MichaelPate/Reflow-Oven-Controller/Control Board/ImagesForFeedbacl/version100/board render angled.png

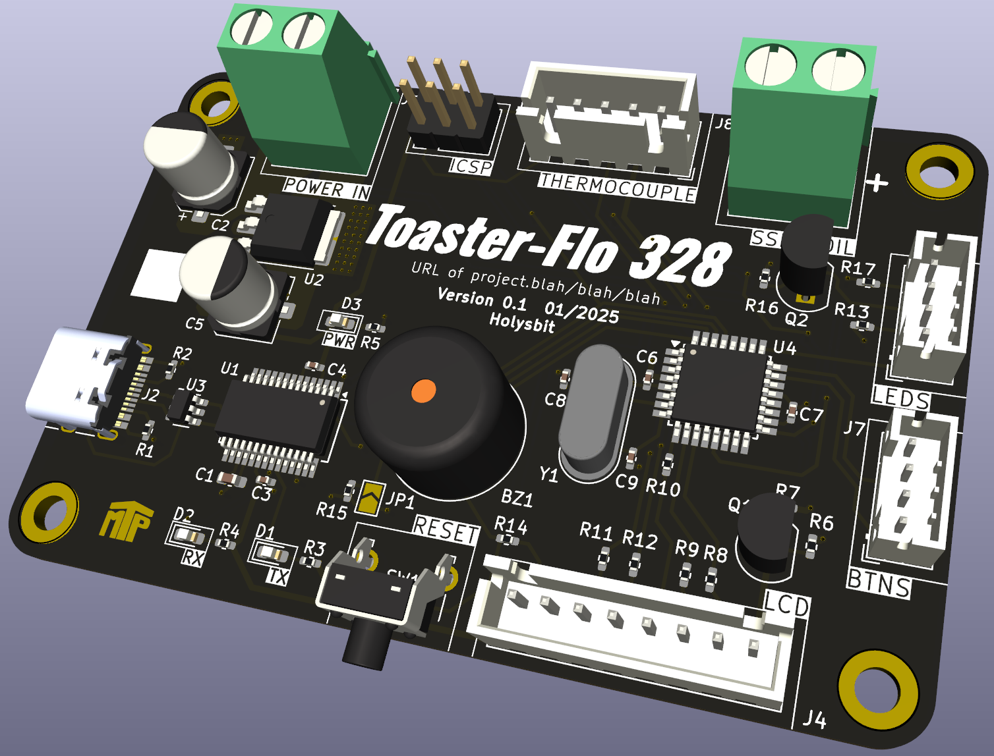
Control Board/ImagesForFeedbacl/version100/board render angled.png
