MichaelPate/Reflow-Oven-Controller/README.md

Toaster-Flo-1769877793309
