MichaelPate/Reflow-Oven-Controller/Control Board/ImagesForFeedbacl/version100/board render straight on.png

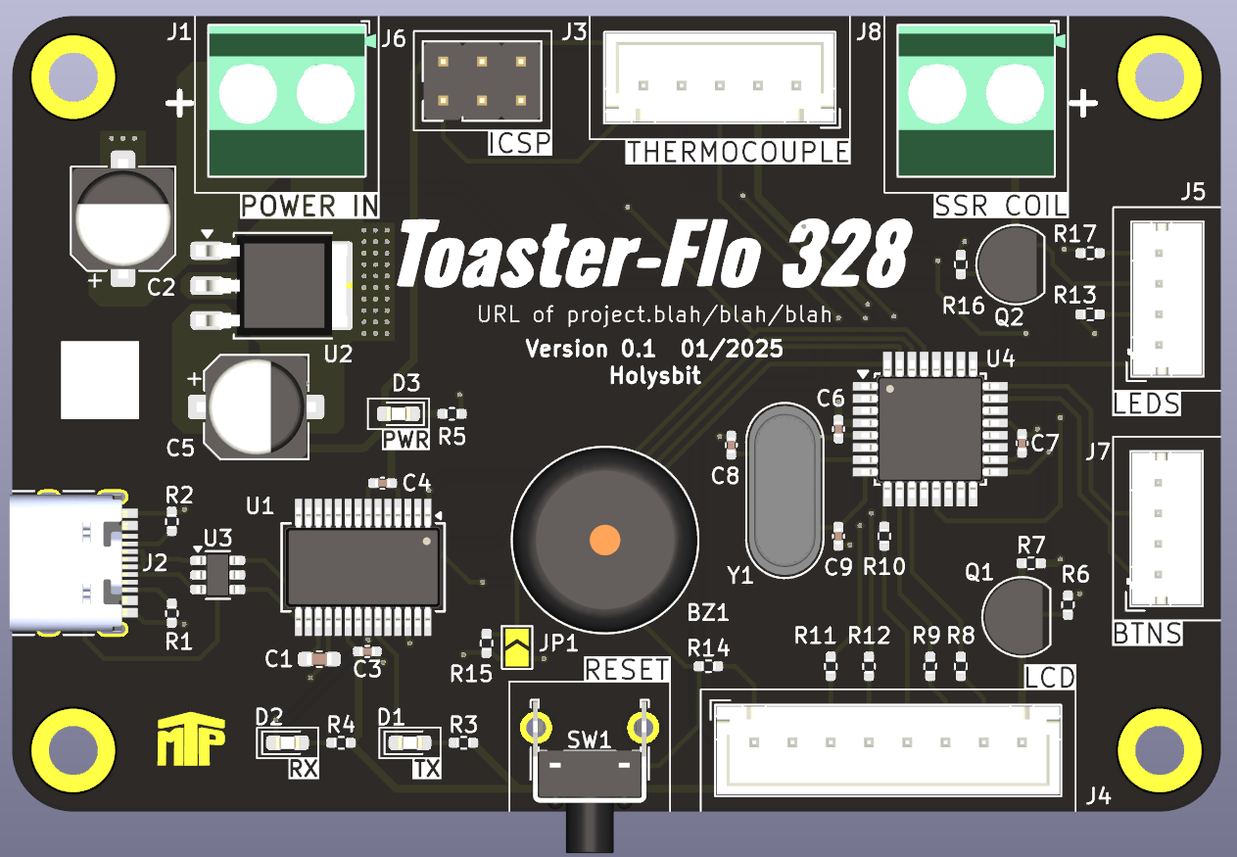
Control Board/ImagesForFeedbacl/version100/board render straight on.png
