MichaelPate/Reflow-Oven-Controller/Control Board/ImagesForFeedbacl/version100/full pcb view all layers.png

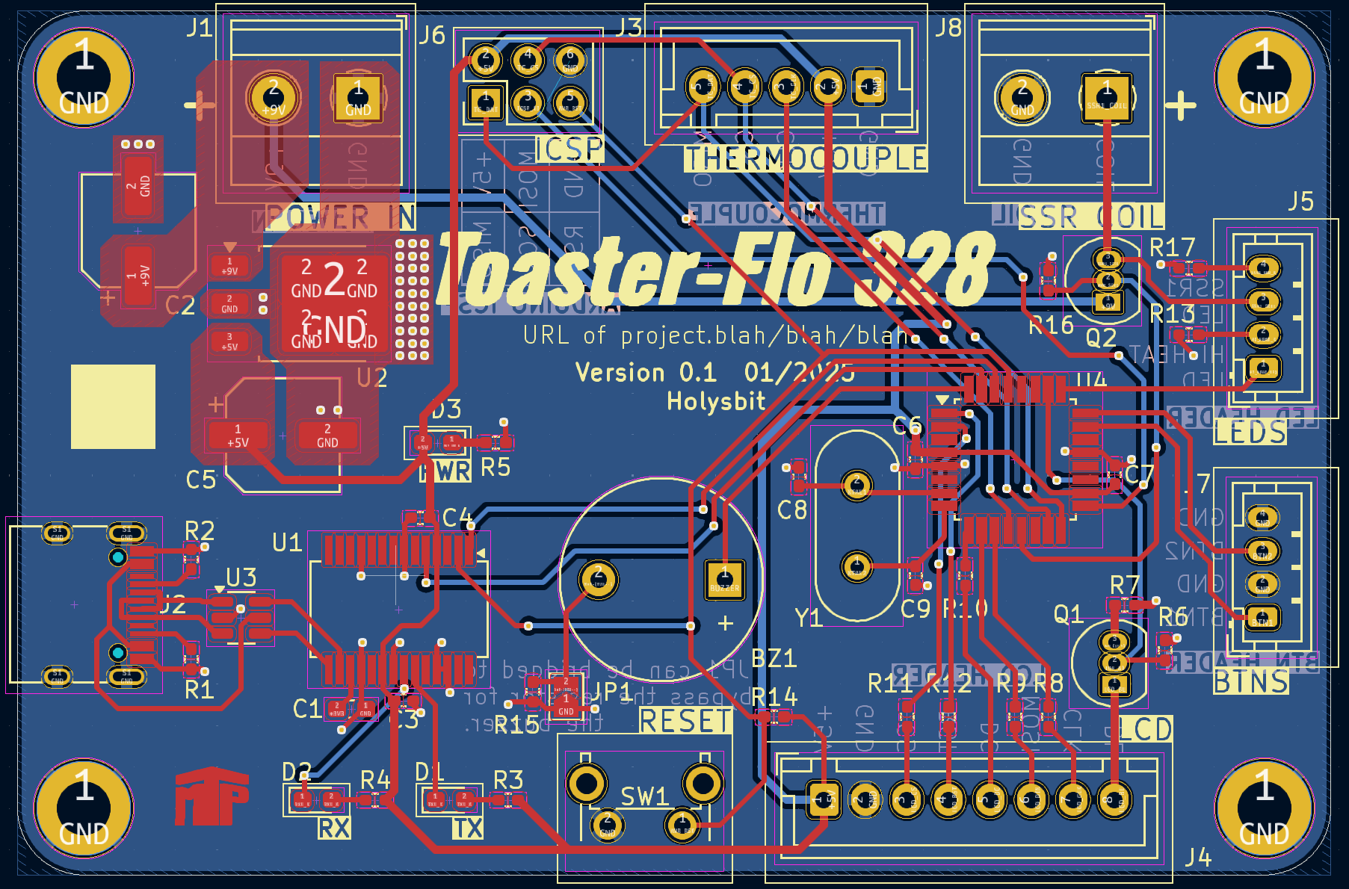
Control Board/ImagesForFeedbacl/version100/full pcb view all layers.png
