MichaelPate/Reflow-Oven-Controller/Control Board/ImagesForFeedbacl/version100/pcb view bottom layer.png

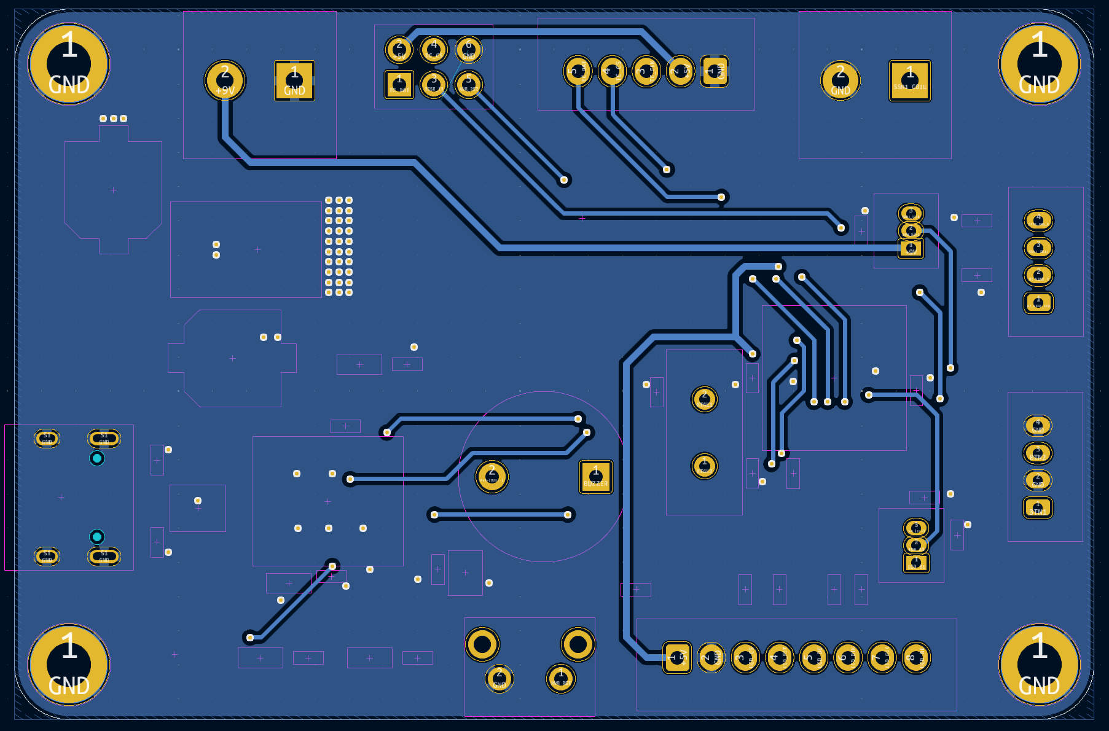
Control Board/ImagesForFeedbacl/version100/pcb view bottom layer.png
