MichaelPate/Reflow-Oven-Controller/Control Board/ImagesForFeedbacl/version100/pcb view top layer.png

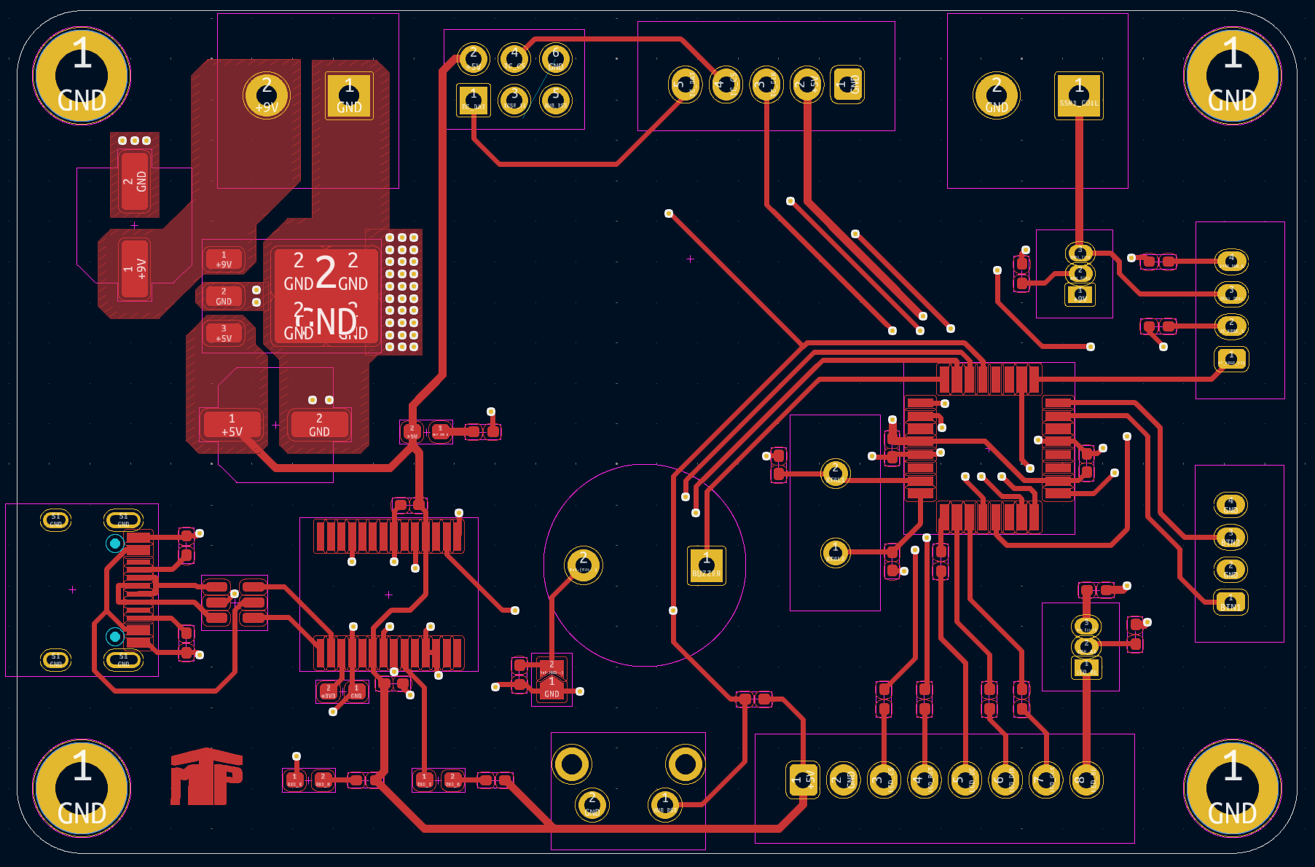
Control Board/ImagesForFeedbacl/version100/pcb view top layer.png
