MichaelPate/Reflow-Oven-Controller/Control Board/ImagesForFeedbacl/version100/schematic.png

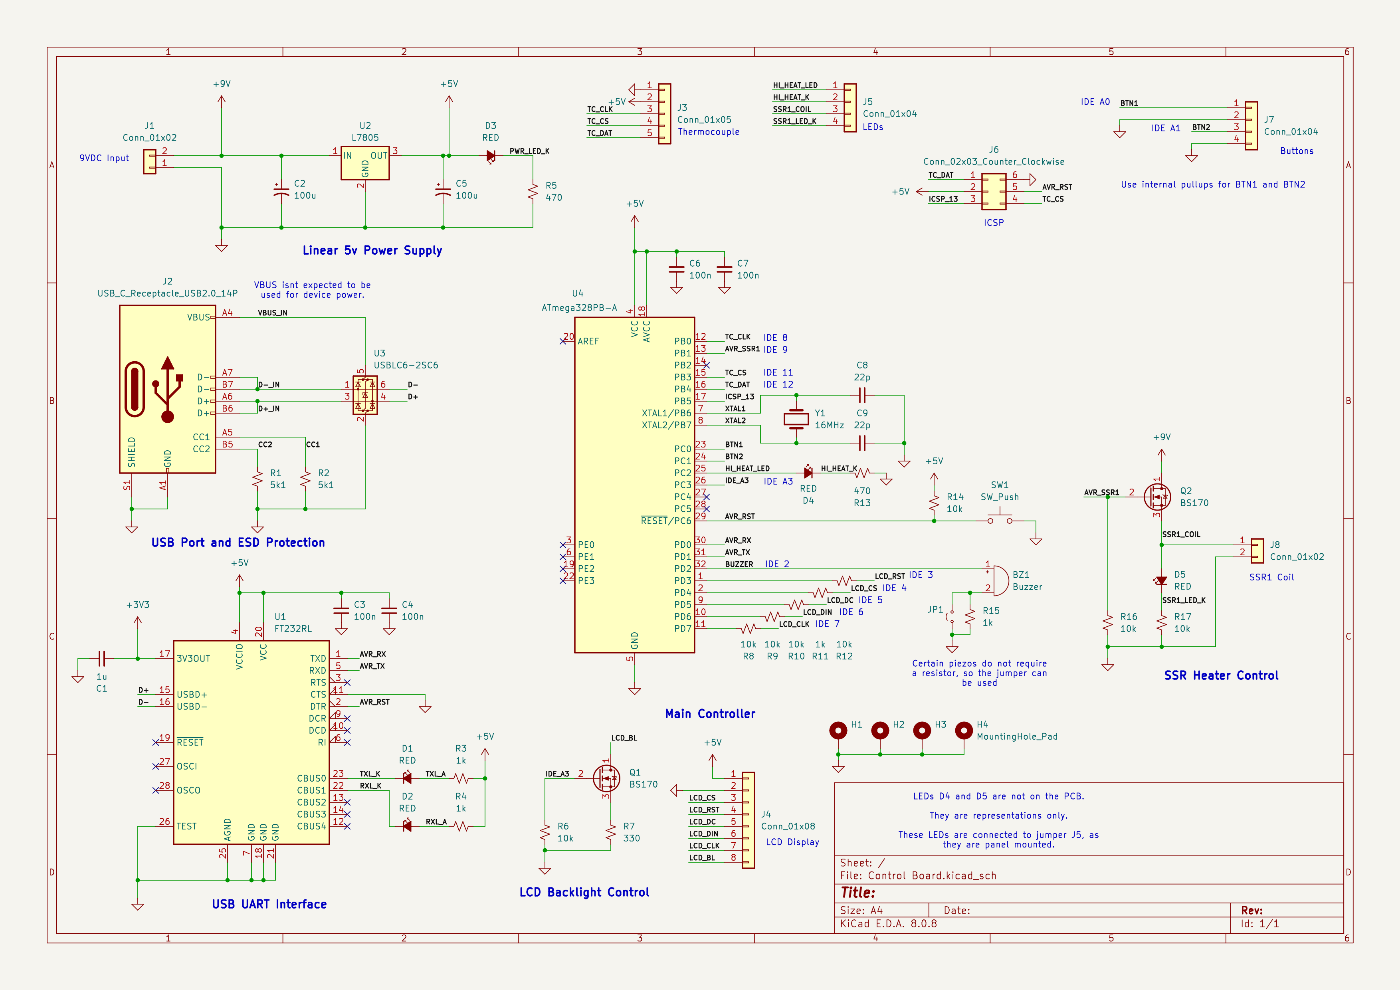
Control Board/ImagesForFeedbacl/version100/schematic.png
