MichaelPate/Reflow-Oven-Controller/Control Board/Control Board.ods

Id | Designator | Footprint | QTY | Designation | Supplier | Mfg PN | Order QTY | Ext. Price | Unit Price
27 | REF** | MTP Logo 5mm Low Detail Copper | 1 | MTP Logo 5mm Low Detail Copper | Not a real part | Not a real part | Not a real part | Not a real part | Not a real part
32 | REF** | michaelpate.net QR Code 5mm | 1 | michaelpate.net QR Code 5mm | Not a real part | Not a real part | Not a real part | Not a real part | Not a real part
30 | C12 | C_0603_1608Metric | 1 | 1u | LCSC | CGA0603X5R105K160JT | 200 | $0.62 | $0.0031
4 | C15,C1,C7,C2,C5,C6 | C_0402_1005Metric | 6 | 100n | LCSC | CGA0402X7R104K160GT | 1000 | $0.60 | $0.0006
23 | C16 | C_0402_1005Metric | 1 | 220n | LCSC | CGA0402X5R224K100GT | 200 | $0.32 | $0.0016
14 | C4 | C_0402_1005Metric | 1 | 10n | LCSC | CGA0402X7R103M500GT | 1000 | $0.70 | $0.0007
18 | C9,C8 | C_0402_1005Metric | 2 | 22p | LCSC | CGA0402C0G220J500GT | 500 | $0.45 | $0.0009
29 | D6,D7 | D_SOD-123 | 2 | MBR0520T1G-JSM | LCSC | MBR0520T1G-JSM | 80 | $2.47 | $0.0309
15 | D8,D2,D3 | LED_0603_1608Metric | 3 | RED | LCSC | XL-1608SURC-06 | 1000 | $2.40 | $0.0024
16 | F2 | Fuse_0603_1608Metric_Pad1.05x0.95mm_HandSolder | 1 | 0603L020/6XR | LCSC | 0603L020/6XR | 60 | $2.63 | $0.0438
26 | FB2 | L_0402_1005Metric | 1 | 33R100MHz | LCSC | CBG100505U330T | 200 | $0.58 | $0.0029
2 | J1,J8 | TerminalBlock_Phoenix_MKDS-1,5-2-5.08_1x02_P5.08mm_Horizontal | 2 | Conn_01x02 | LCSC | JL500-50802G01 | 50 | $5.83 | $0.1166
7 | J2 | USB_C_Receptacle_HRO_TYPE-C-31-M-12 | 1 | USB_C_Receptacle_USB2.0_14P | LCSC | TYPE-C-31-M-12 | 100 | $13.67 | $0.1367
20 | J3 | JST_XH_B5B-XH-A_1x05_P2.50mm_Vertical | 1 | Conn_01x05 | LCSC | B5B-XH-A(LF)(SN) | 35 | $2.52 | $0.0720
21 | J4 | JST_XH_B8B-XH-A_1x08_P2.50mm_Vertical | 1 | Conn_01x08 | LCSC | B8B-XH-A(LF)(SN) | 20 | $1.98 | $0.0990
19 | J6 | PinHeader_2x03_P2.54mm_Vertical | 1 | Conn_02x03_Counter_Clockwise | LCSC | P125-1140A0BS116A1 | 25 | $5.32 | $0.2128
3 | J7,J5 | JST_PH_B4B-PH-K_1x04_P2.00mm_Vertical | 2 | Conn_01x04 | LCSC | B4B-PH-K-S(LF)(SN) | 50 | $1.99 | $0.0398
5 | Q4,Q3 | SOT-23 | 2 | AO3414-HXY | LCSC | AO3414-HXY | 150 | $2.25 | $0.0150
11 | R1,R2 | R_0402_1005Metric | 2 | 5k1 | LCSC | RTT02512JTH | 1000 | $0.40 | $0.0004
9 | R13,R9 | R_0402_1005Metric | 2 | 470 | LCSC | RTT02471JTH | 1000 | $0.40 | $0.0004
6 | R16,R21,R14,R20,R18,R17,R6,R22 | R_0402_1005Metric | 8 | 10k | LCSC | SCR0402J10K | 1000 | $0.30 | $0.0003
1 | R5,R19,R4,R15 | R_0402_1005Metric | 4 | 1k | LCSC | SCR0402J1K | 1000 | $0.30 | $0.0003
24 | R7 | R_0402_1005Metric | 1 | 330 | LCSC | SCR0402F330R | 1000 | $0.40 | $0.0004
31 | R8 | R_0402_1005Metric | 1 | 0 | LCSC | SCR0402J0R | 1000 | $0.30 | $0.0003
17 | SW1 | SW_Tactile_SPST_Angled_PTS645Vx58-2LFS | 1 | SW_Push | LCSC | PTS645VL83-2 LFS | 55 | $3.82 | $0.0695
8 | U1 | TO-252-3_TabPin2 | 1 | L7805 | LCSC | BA7805FP-E2 | 40 | $13.66 | $0.3415
25 | U2 | SOT-23-6 | 1 | USBLC6-2SC6 | LCSC | USBLC6-2SC6 | 100 | $1.65 | $0.0165
13 | U3 | SSOP-28_5.3x10.2mm_P0.65mm | 1 | FT232RL | LCSC | FT232RL-REEL | 6 | $24.65 | $4.1083
22 | U5 | TQFP-32_7x7mm_P0.8mm | 1 | ATmega328PB-A | LCSC | ATMEGA328PB-AU | 10 | $17.50 | $1.7500
28 | Y2 | Crystal_SMD_3225-4Pin_3.2x2.5mm | 1 | 16MHz | LCSC | CF4016M00020001 | 40 | $2.19 | $0.0548
10 | C13 | CP_Elec_4x5.4 | 1 | 4u7 | DigiKey | 10SVP4R7M | 5 | $6.60 | $1.3200
12 | BZ1 | Buzzer_12x9.5RM7.6 | 1 | Buzzer | Amazon | CYT1008 | 10 | $5.99 | $0.5990
 |  |  |  |  |  |  |  | $122.49
