MichaelPate/Reflow-Oven-Controller/Control Board/plots/Control Board__Assembly.pdf

1 | 2 | 3 | 4 | 5 | 6

A

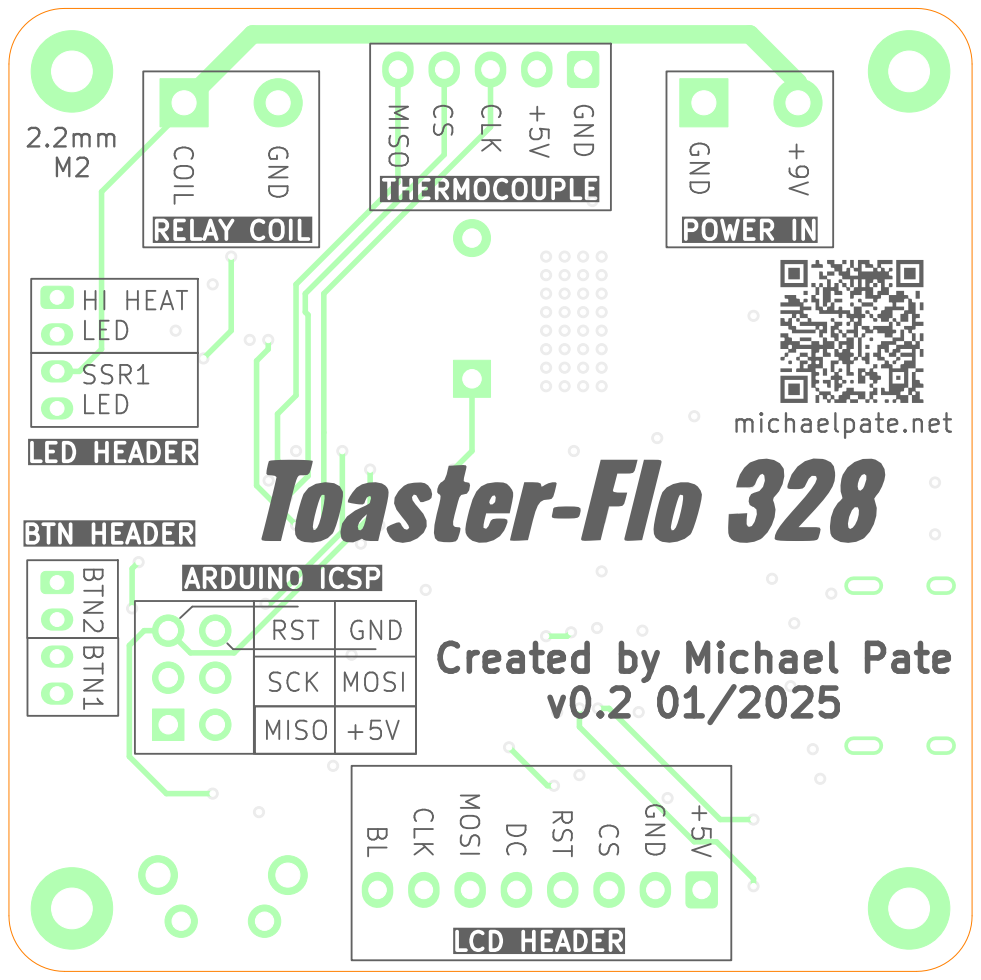
[picture p8: page 1]
RST MISO BTN1; Created; Michael; Pate; v0.2 01/2025 MOSI; CLK +5V DC CLKBL COIL; GND MOSI BTN2; 2.2mm M2SSR1; LED; GND; michaelpate.net CS HI; HEAT; SCK GND; +5V MISO; RST GND; D Date: KiCad; E.D.A. 8.0.8 Size: A4; Rev:; Id: 1/1 Title: File: Control; Board.kicad_pcb Sheet: Colored; BOT Board2Pdf:; Colored; BOT -; Page

1 | 2 | 3 | 4 | 5 | 6

A

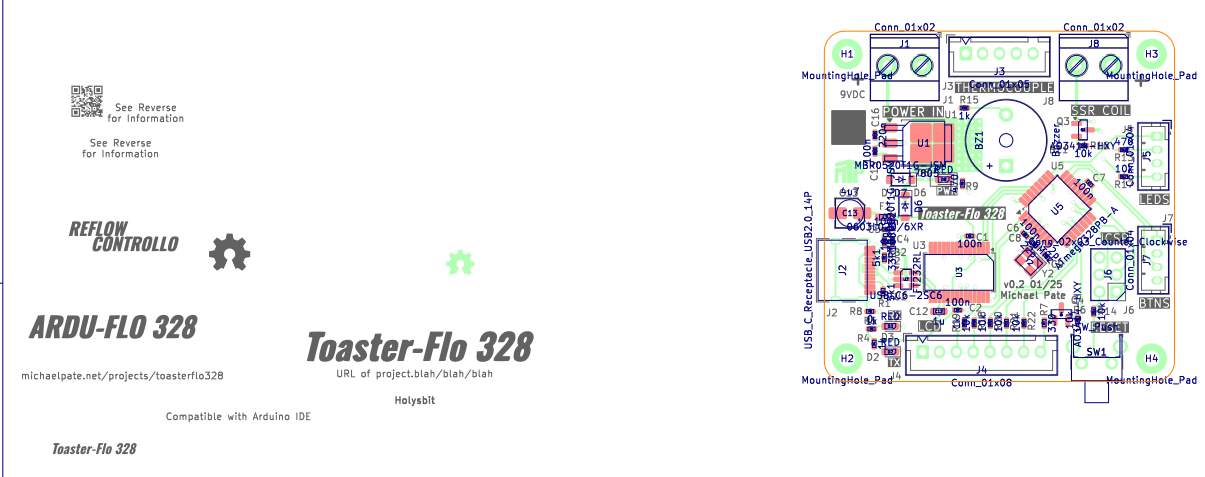
[picture p9: page 2]
