MichaelPate/Reflow-Oven-Controller/Hardware/TC Front End/front-end/front-end.kicad_pcb

## KiCad design Hardware/TC Front End/front-end/front-end.kicad_pcb (2025-10-18)

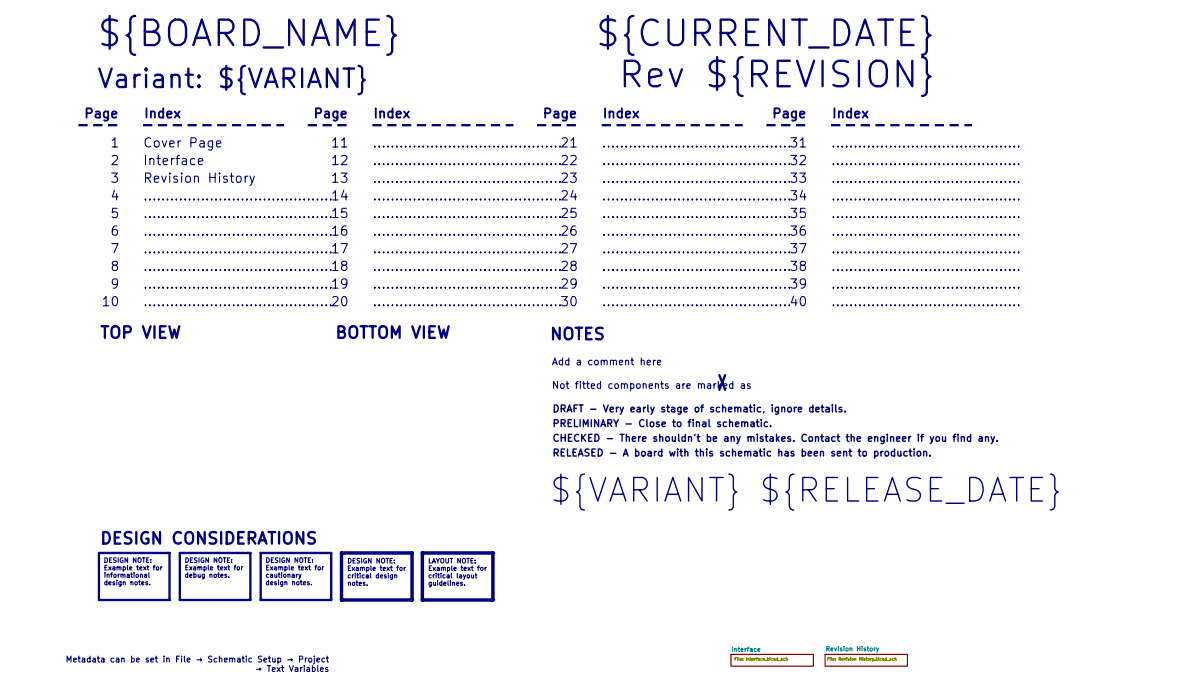
[picture p10: schematic front-end.kicad_sch, Cover Page]

Notes on the sheet:
BOTTOM VIEW
...........................................
RELEASED - A board with this schematic has been sent to production.
Page
TOP VIEW
Not fitted components are marked as
Index
PRELIMINARY - Close to final schematic.
${VARIANT} ${RELEASE_DATE}
${CURRENT_DATE}
Variant: ${VARIANT}
Rev ${REVISION}
${BOARD_NAME}
DRAFT - Very early stage of schematic, ignore details.
Interface
Add a comment here
Cover Page
NOTES
Revision History
CHECKED - There shouldn't be any mistakes. Contact the engineer if you find any.
DESIGN CONSIDERATIONS
Metadata can be set in File → Schematic Setup → Project → Text Variables
DESIGN NOTE: Example text for informational design notes.
LAYOUT NOTE: Example text for critical layout guidelines.
DESIGN NOTE: Example text for cautionary design notes.
DESIGN NOTE: Example text for debug notes.
DESIGN NOTE: Example text for critical design notes.


Notes on the sheet:
- _________________________________ - _________________________________ - _________________________________ - _________________________________ - _________________________________ - _________________________________ - _________________________________ - _________________________________ - _________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
DD.MM.YYYY - xxx Revision Variant: xxx
[${#}] ${TITLE}

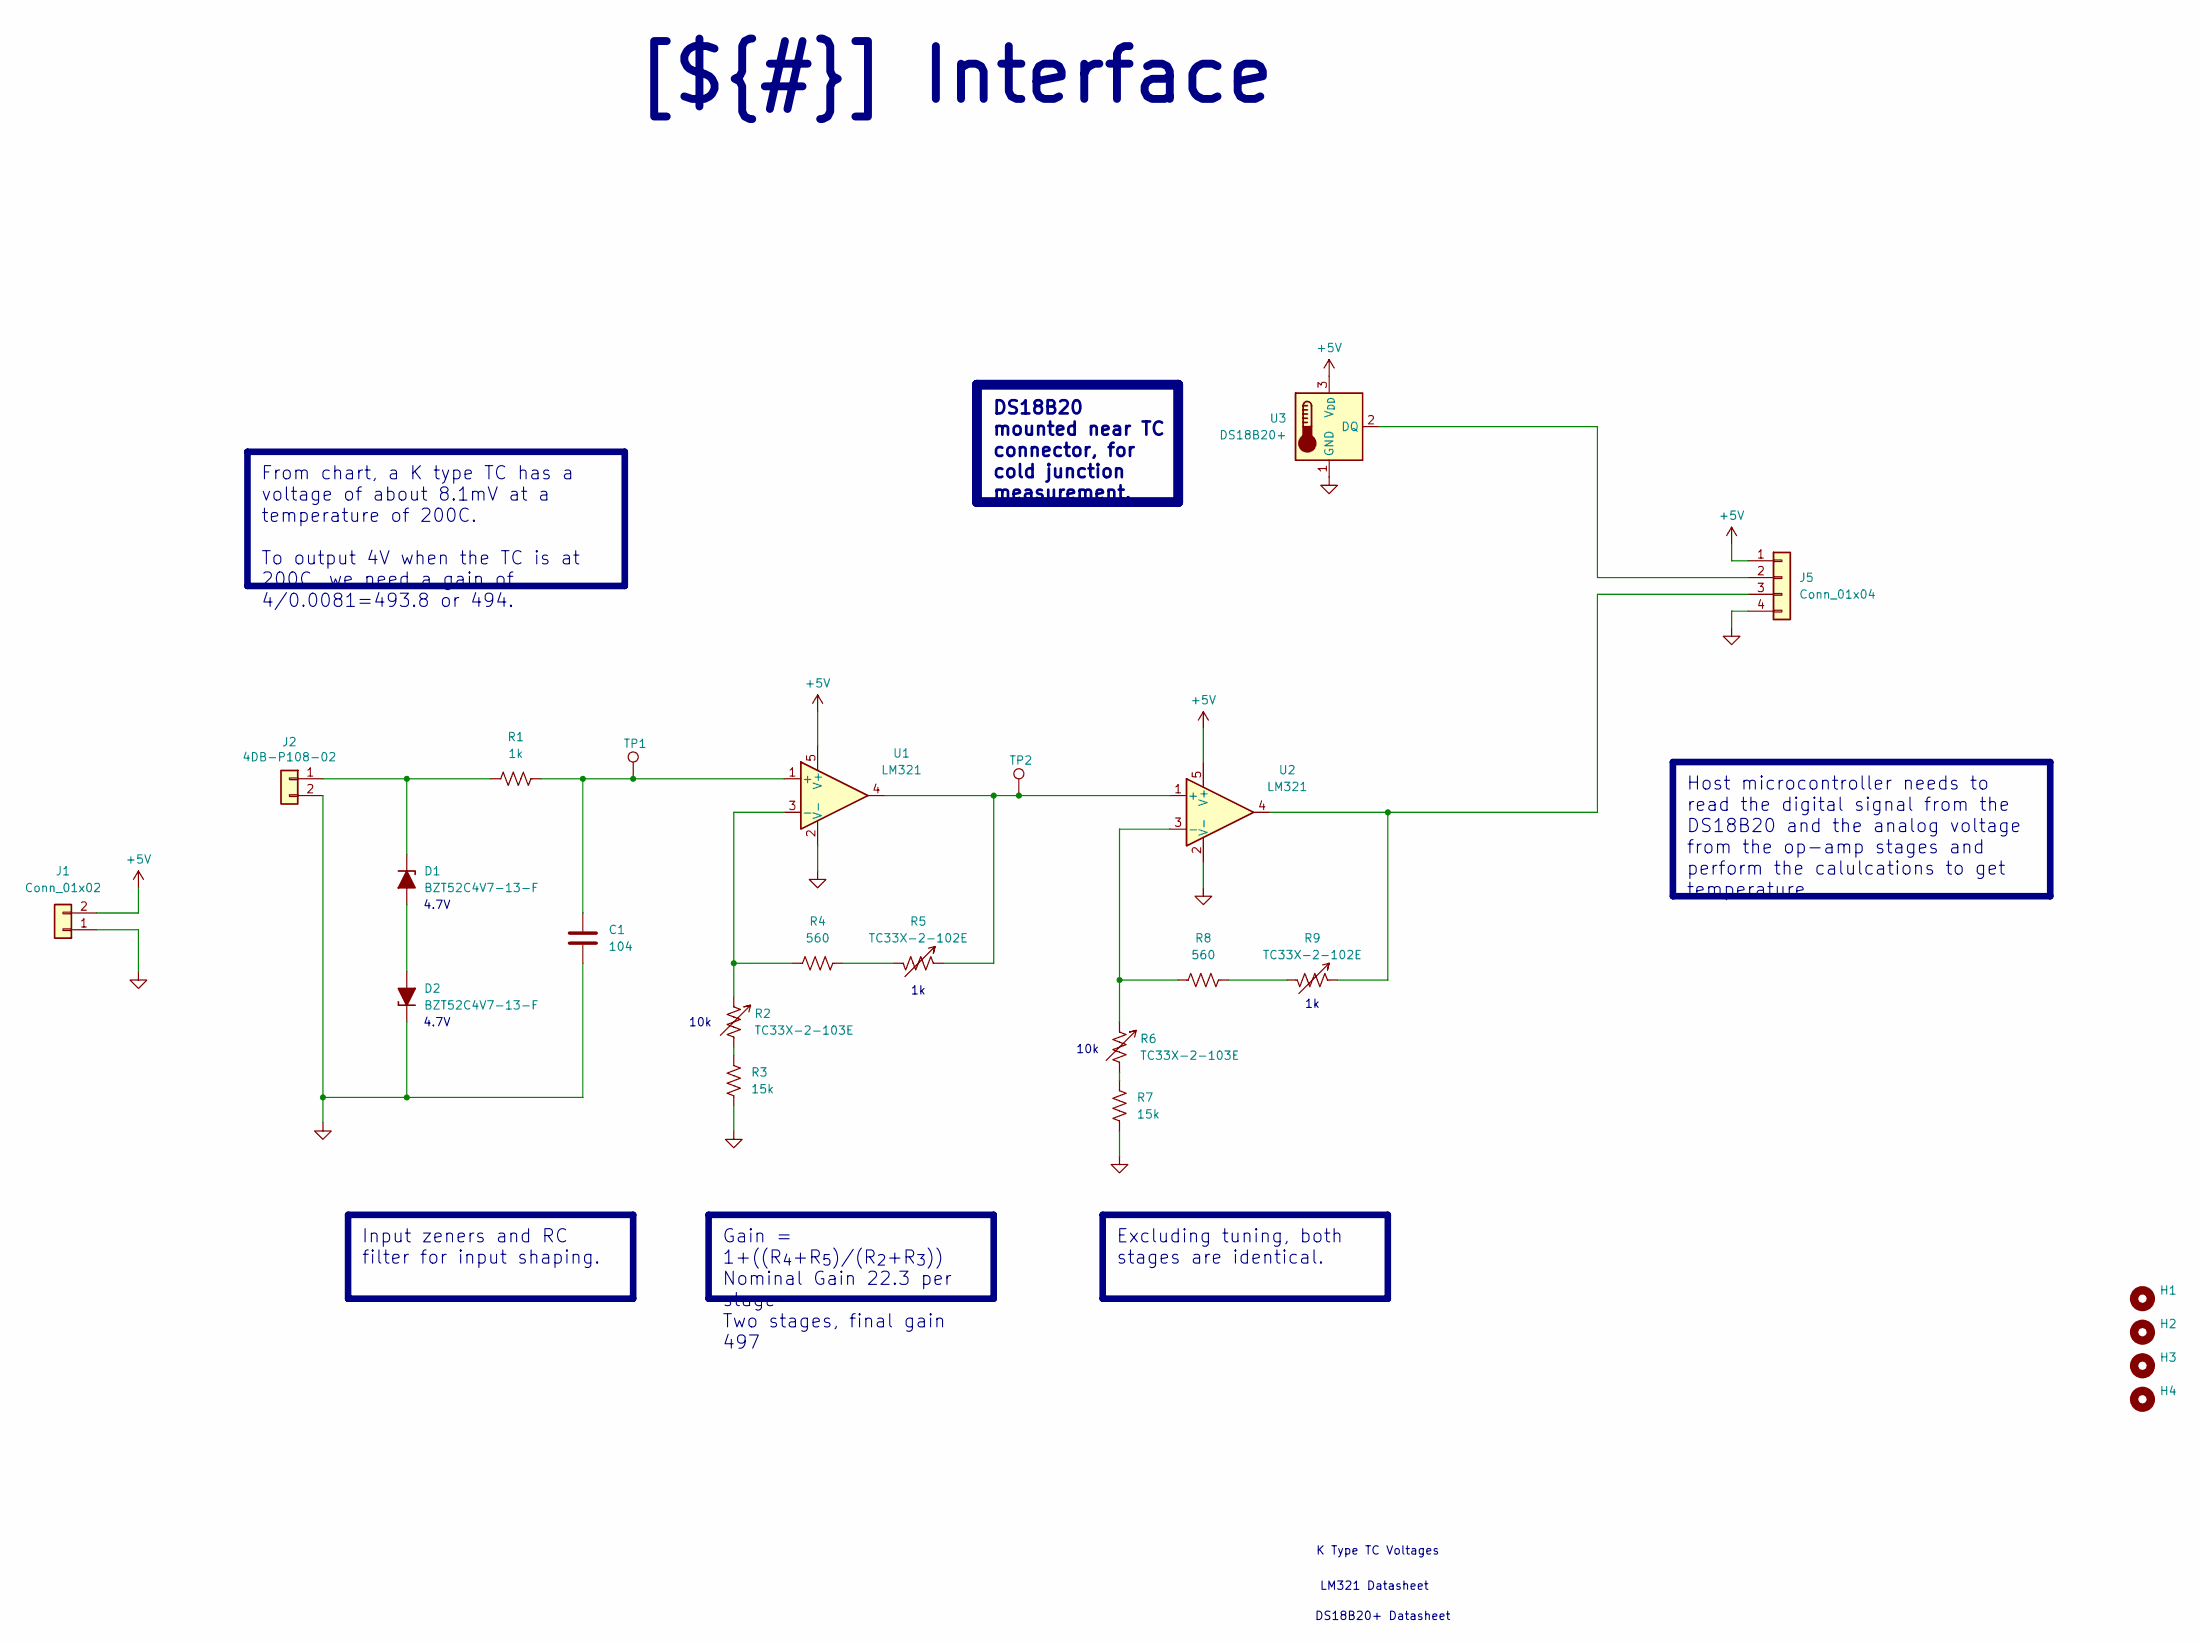
[picture p12: schematic Interface.kicad_sch]

Parts:
C1: 104; C_0603_1608Metric_Pad1.08x0.95mm_HandSolder
D1, D2: BZT52C4V7-13-F; D_SOD-123
H1, H2, H3, H4: MountingHole; MountingHole_3.2mm_M3
J1: Conn_01x02; TerminalBlock_Phoenix_MKDS-1,5-2_1x02_P5.00mm_Horizontal
J2: 4DB-P108-02; CONN_4DB-P108-02_TEC
J5: Conn_01x04; PinHeader_1x04_P2.54mm_Vertical
R1: 1k; R_0603_1608Metric_Pad0.98x0.95mm_HandSolder
R2, R6: TC33X-2-103E; Potentiometer_Bourns_TC33X_Vertical
R3, R7: 15k; R_0603_1608Metric_Pad0.98x0.95mm_HandSolder
R4, R8: 560; R_0603_1608Metric_Pad0.98x0.95mm_HandSolder
R5, R9: TC33X-2-102E; Potentiometer_Bourns_TC33X_Vertical
TP1, TP2: TestPoint; TestPoint_THTPad_D2.0mm_Drill1.0mm
U1, U2: LM321; SOT-23-5
U3: DS18B20+; TO-92_Inline

Connections:
+5V: J1.2, J5.1, U1.5 (V+), U2.5 (V+), U3.3 (V_{DD})
GND: C1.2, D2.1 (K), J1.1, J2.2, J5.4, R3.2, R7.2, U1.2 (V-), U2.2 (V-), U3.1 (GND)
unnamed: D1.2 (A), D2.2 (A)
unnamed: D1.1 (K), J2.1, R1.1
unnamed: J5.2, U3.2 (DQ)
unnamed: J5.3, R9.1, U2.4
unnamed: R2.2, R3.1
unnamed: R4.2, R5.2
unnamed: R6.2, R7.1
unnamed: R8.2, R9.2
unnamed: C1.1, R1.2, TP1.1, U1.1 (+)
unnamed: R2.1, R4.1, U1.3 (-)
unnamed: R5.1, TP2.1, U1.4, U2.1 (+)
unnamed: R6.1, R8.1, U2.3 (-)

Notes on the sheet:
4.7V
K Type TC Voltages
10k
LM321 Datasheet
DS18B20+ Datasheet
DS18B20 mounted near TC connector, for cold junction measurement.
Gain = 1+((R_{4}+R_{5})/(R_{2}+R_{3})) Nominal Gain 22.3 per stage Two stages, final gain 497
Input zeners and RC filter for input shaping.
Excluding tuning, both stages are identical.
[${#}] ${TITLE}
Host microcontroller needs to read the digital signal from the DS18B20 and the analog voltage from the op-amp stages and perform the calulcations to get temperature.
From chart, a K type TC has a voltage of about 8.1mV at a temperature of 200C. To output 4V when the TC is at 200C, we need a gain of 4/0.0081=493.8 or 494.

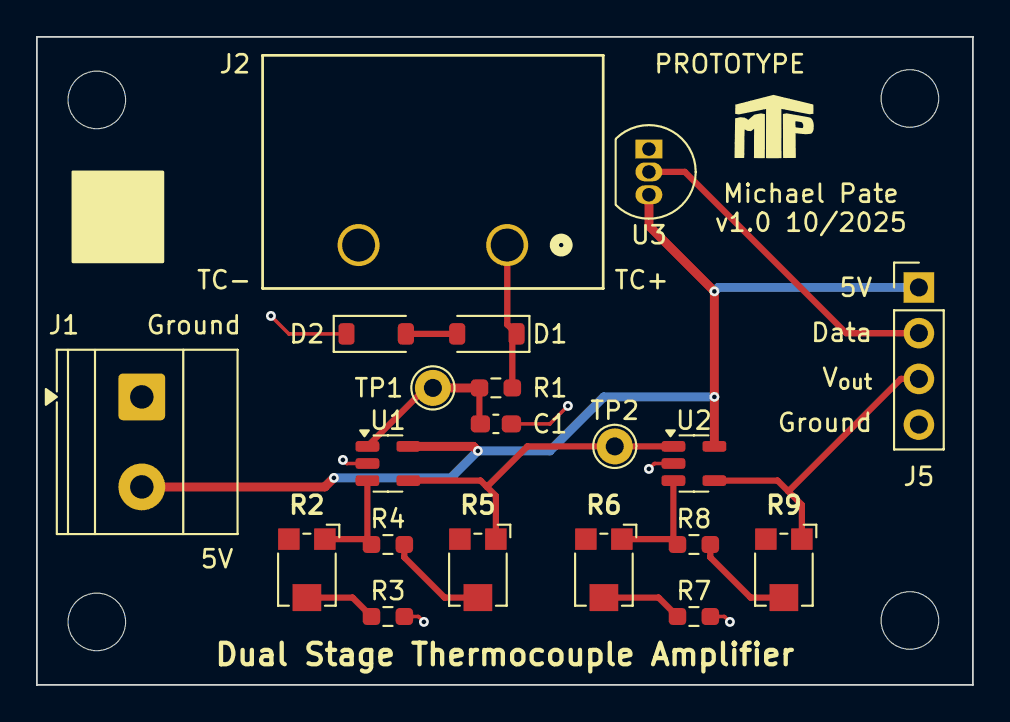
[picture p13: board front-end.kicad_pcb from above]

Board: 2 copper layers, 52.0 x 36.0 mm, 24 parts (0 on the bottom side), 14 nets.
