MichaelPate/Reflow-Oven-Controller/Hardware/Power Board/powerBoard/powerBoard.kicad_pcb

## KiCad design Hardware/Power Board/powerBoard/powerBoard.kicad_pcb (2025-10-24)

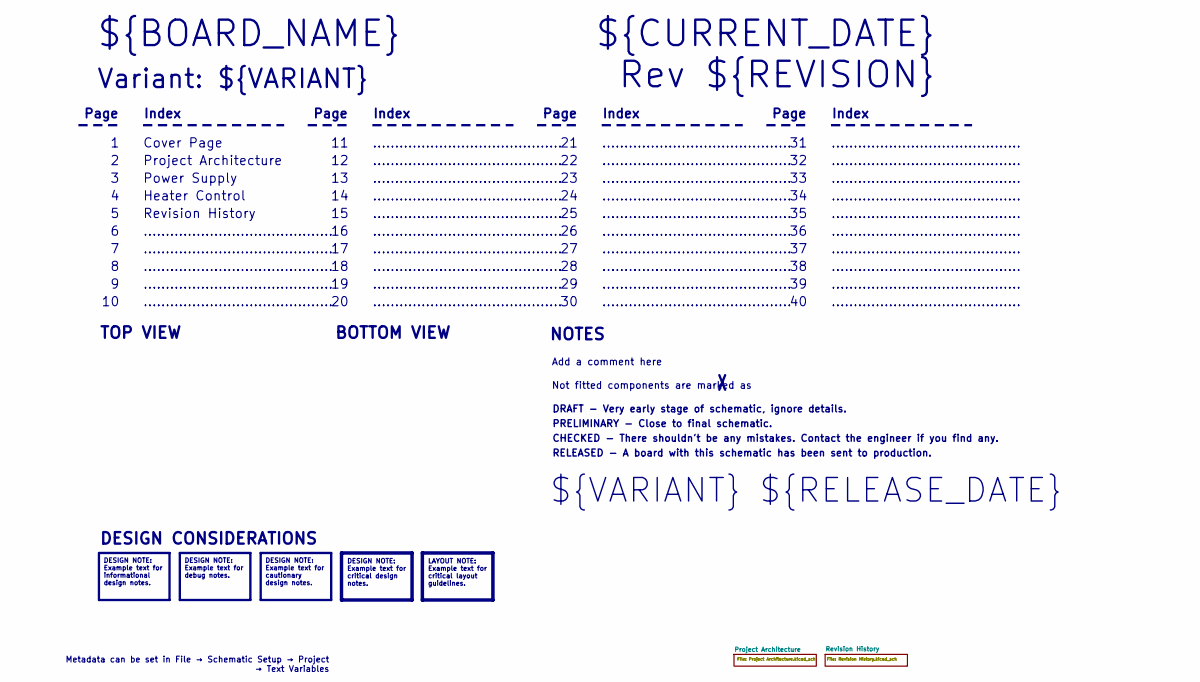
[picture p14: schematic powerBoard.kicad_sch, Cover Page]

Notes on the sheet:
BOTTOM VIEW
...........................................
RELEASED - A board with this schematic has been sent to production.
Page
TOP VIEW
Not fitted components are marked as
Index
PRELIMINARY - Close to final schematic.
${VARIANT} ${RELEASE_DATE}
Heater Control
${CURRENT_DATE}
Variant: ${VARIANT}
Rev ${REVISION}
Revision History
${BOARD_NAME}
DRAFT - Very early stage of schematic, ignore details.
Project Architecture
Add a comment here
Cover Page
NOTES
Power Supply
CHECKED - There shouldn't be any mistakes. Contact the engineer if you find any.
DESIGN CONSIDERATIONS
Metadata can be set in File → Schematic Setup → Project → Text Variables
DESIGN NOTE: Example text for informational design notes.
LAYOUT NOTE: Example text for critical layout guidelines.
DESIGN NOTE: Example text for cautionary design notes.
DESIGN NOTE: Example text for debug notes.
DESIGN NOTE: Example text for critical design notes.

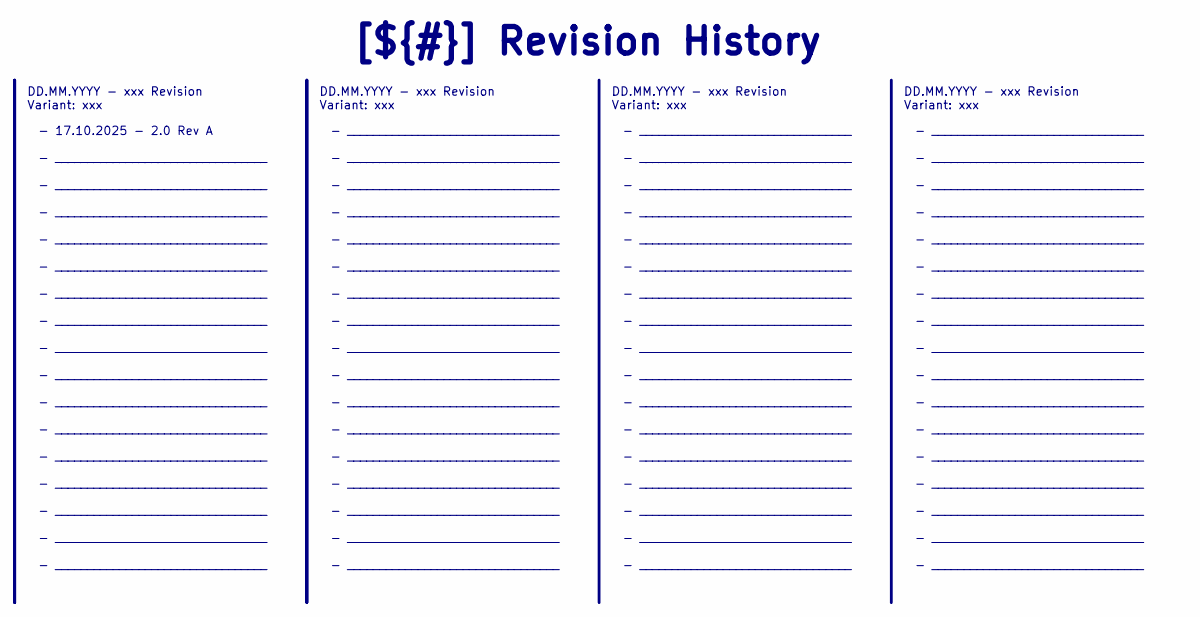
[picture p15: schematic Revision History.kicad_sch]

Notes on the sheet:
- _________________________________ - _________________________________ - _________________________________ - _________________________________ - _________________________________ - _________________________________ - _________________________________ - _________________________________ - _________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
DD.MM.YYYY - xxx Revision Variant: xxx
[${#}] ${TITLE}
- 17.10.2025 - 2.0 Rev A - _________________________________ - _________________________________ - _________________________________ - _________________________________ - _________________________________ - _________________________________ - _________________________________ - ____________________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

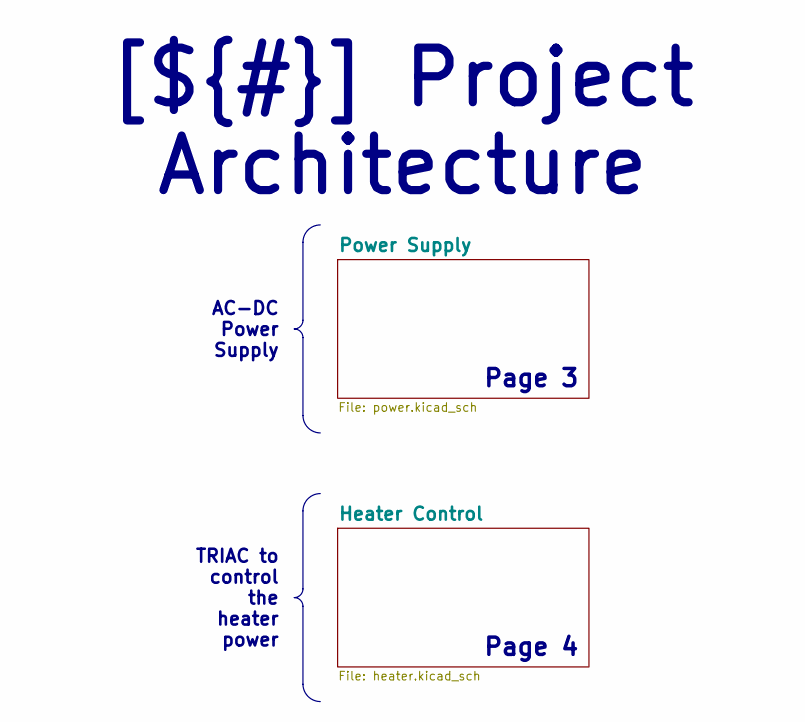
[picture p16: schematic Project Architecture.kicad_sch]

Notes on the sheet:
Page 4
Page 3
AC-DC Power Supply
[${#}] ${TITLE}
TRIAC to control the heater power

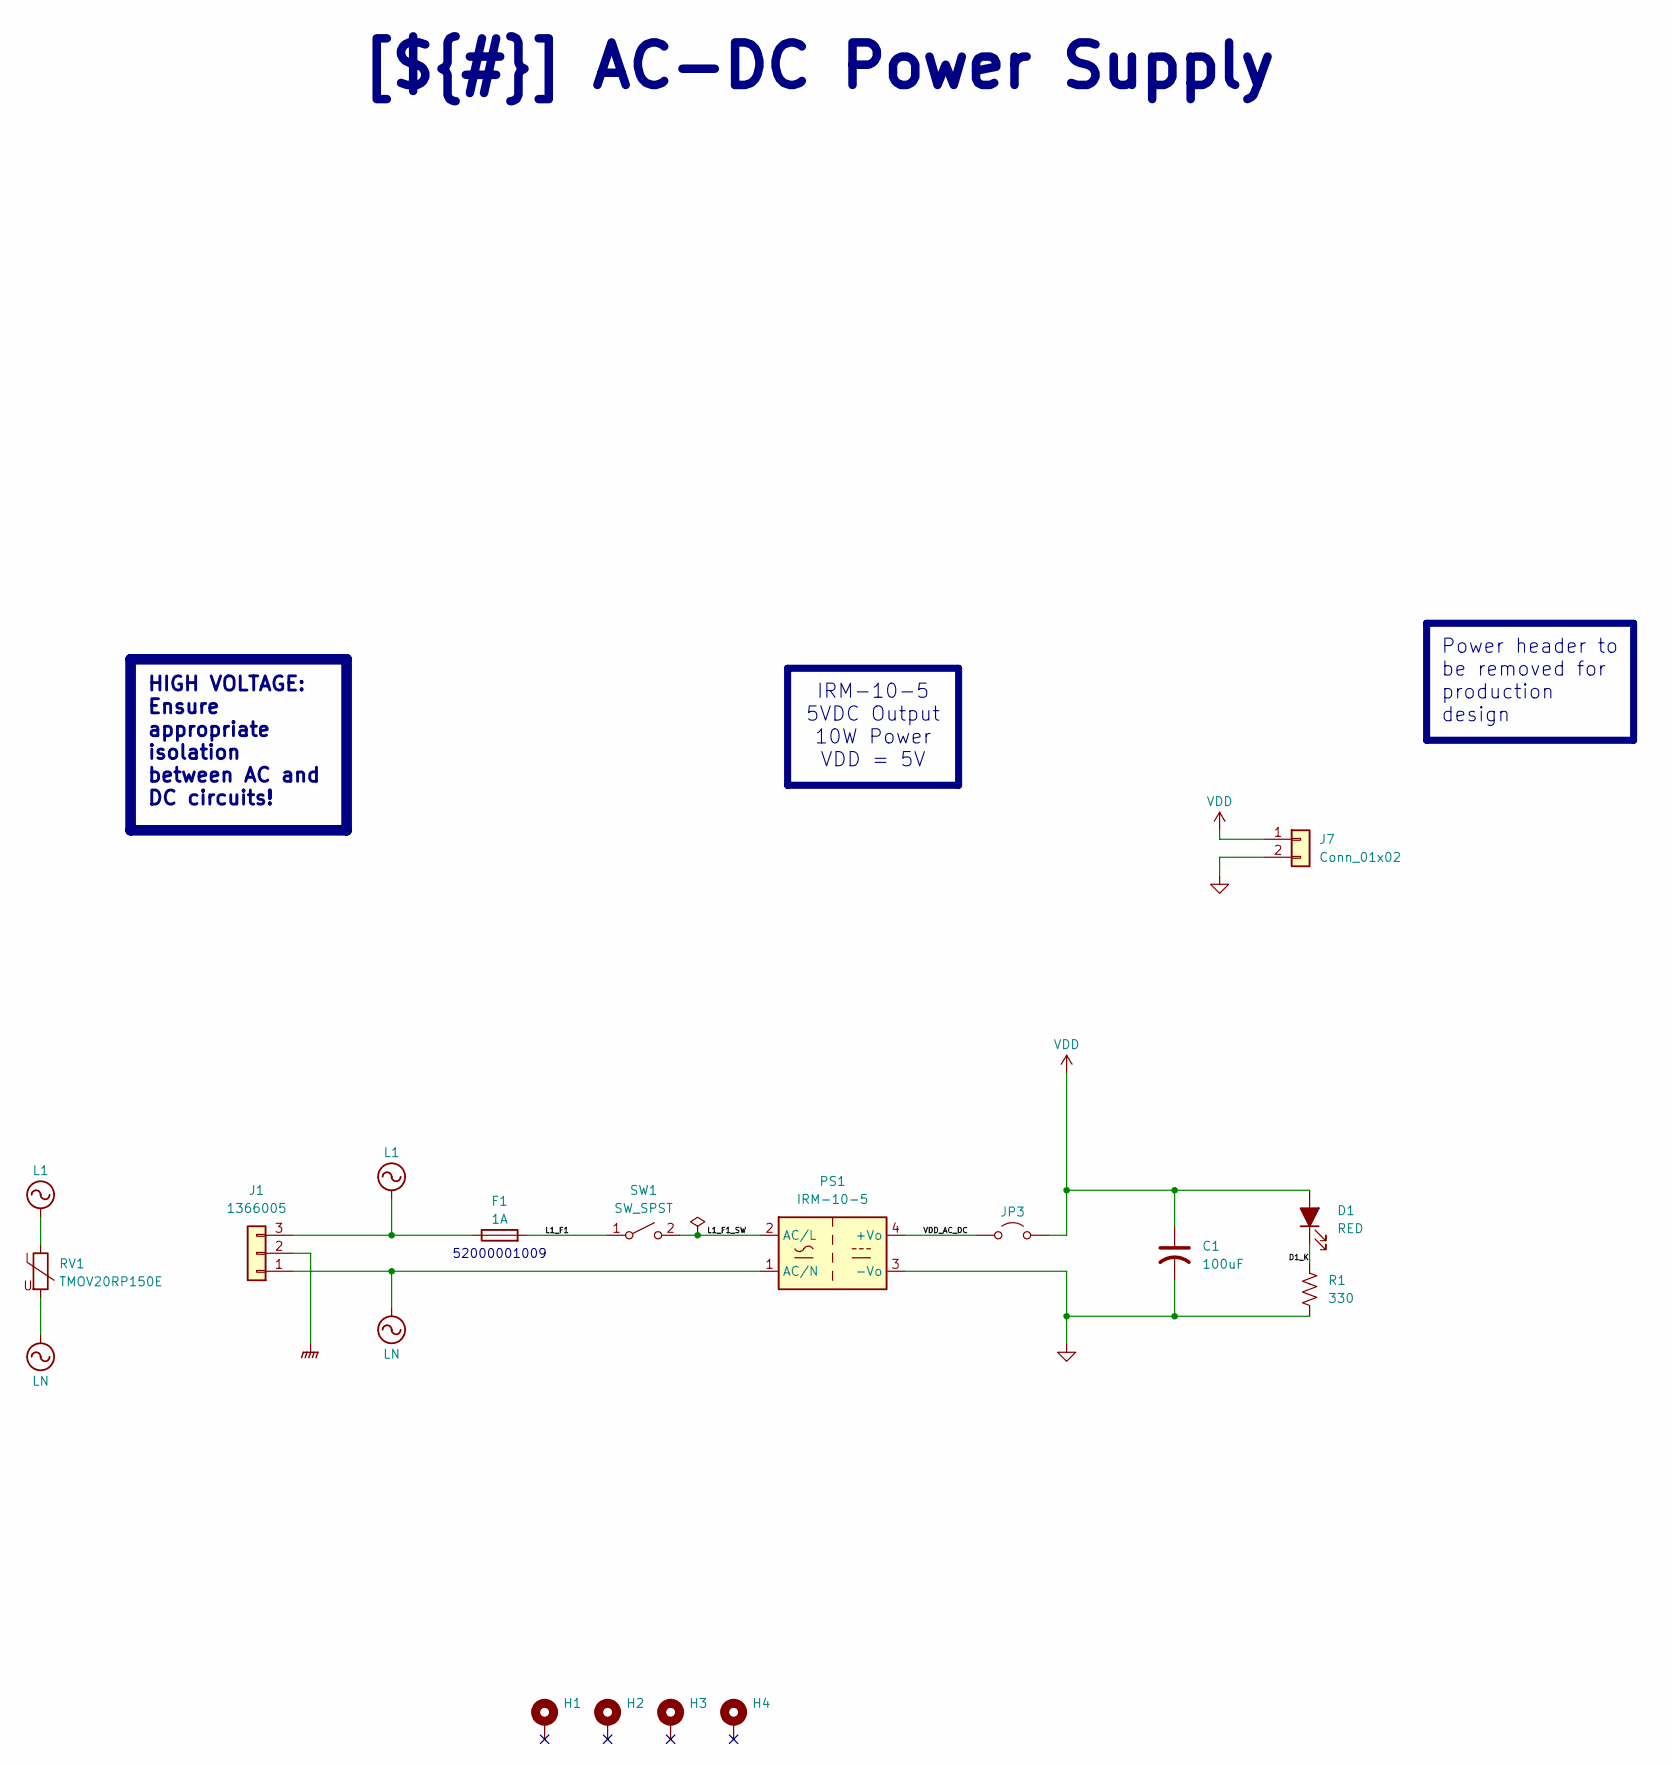
[picture p17: schematic power.kicad_sch, AC-DC Power Supply]

Parts:
C1: 100uF; C_Radial_D5.0mm_H5.0mm_P2.00mm
D1: RED; LED_0603_1608Metric_Pad1.05x0.95mm_HandSolder
F1: 1A; Fuseholder_Clip-5x20mm_Littelfuse_100_Inline_P20.50x4.60mm_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
H1, H2, H3, H4: MountingHole_Pad; MountingHole_2.5mm
J1: 1366005; SPTA-THR 2.53-5.0 P26
J7: Conn_01x02; TerminalBlock_Phoenix_MKDS-1,5-2-5.08_1x02_P5.08mm_Horizont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
JP3: Jumper_2_Open; PinHeader_1x02_P2.54mm_Vertical
PS1: IRM-10-5; Converter_ACDC_MeanWell_IRM-10-xx_THT
R1: 330; R_0603_1608Metric_Pad0.98x0.95mm_HandSolder
RV1: TMOV20RP150E
SW1: SW_SPST; TerminalBlock_Phoenix_MKDS-1,5-2-5.08_1x02_P5.08mm_Horizont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

Connections:
/Project Architecture/Power Supply/D1_K: D1.1 (K), R1.1
/Project Architecture/Power Supply/L1_F1: F1.2, SW1.1 (A)
/Project Architecture/Power Supply/L1_F1_SW: PS1.2 (AC/L), SW1.2 (B)
/Project Architecture/Power Supply/VDD_AC_DC: JP3.1 (A), PS1.4 (+Vo)
GND: C1.2, J7.2, PS1.3 (-Vo), R1.2; also elsewhere on the board
GNDPWR: J1.2; also elsewhere on the board
L1: F1.1, J1.3, RV1.1; also elsewhere on the board
LN: J1.1, PS1.1 (AC/N), RV1.2; also elsewhere on the board
VDD: C1.1, D1.2 (A), J7.1, JP3.2 (B); also elsewhere on the board

Notes on the sheet:
52000001009
IRM-10-5 5VDC Output 10W Power VDD = 5V
Power header to be removed for production design
[${#}] ${TITLE}
HIGH VOLTAGE: Ensure appropriate isolation between AC and DC circuits!

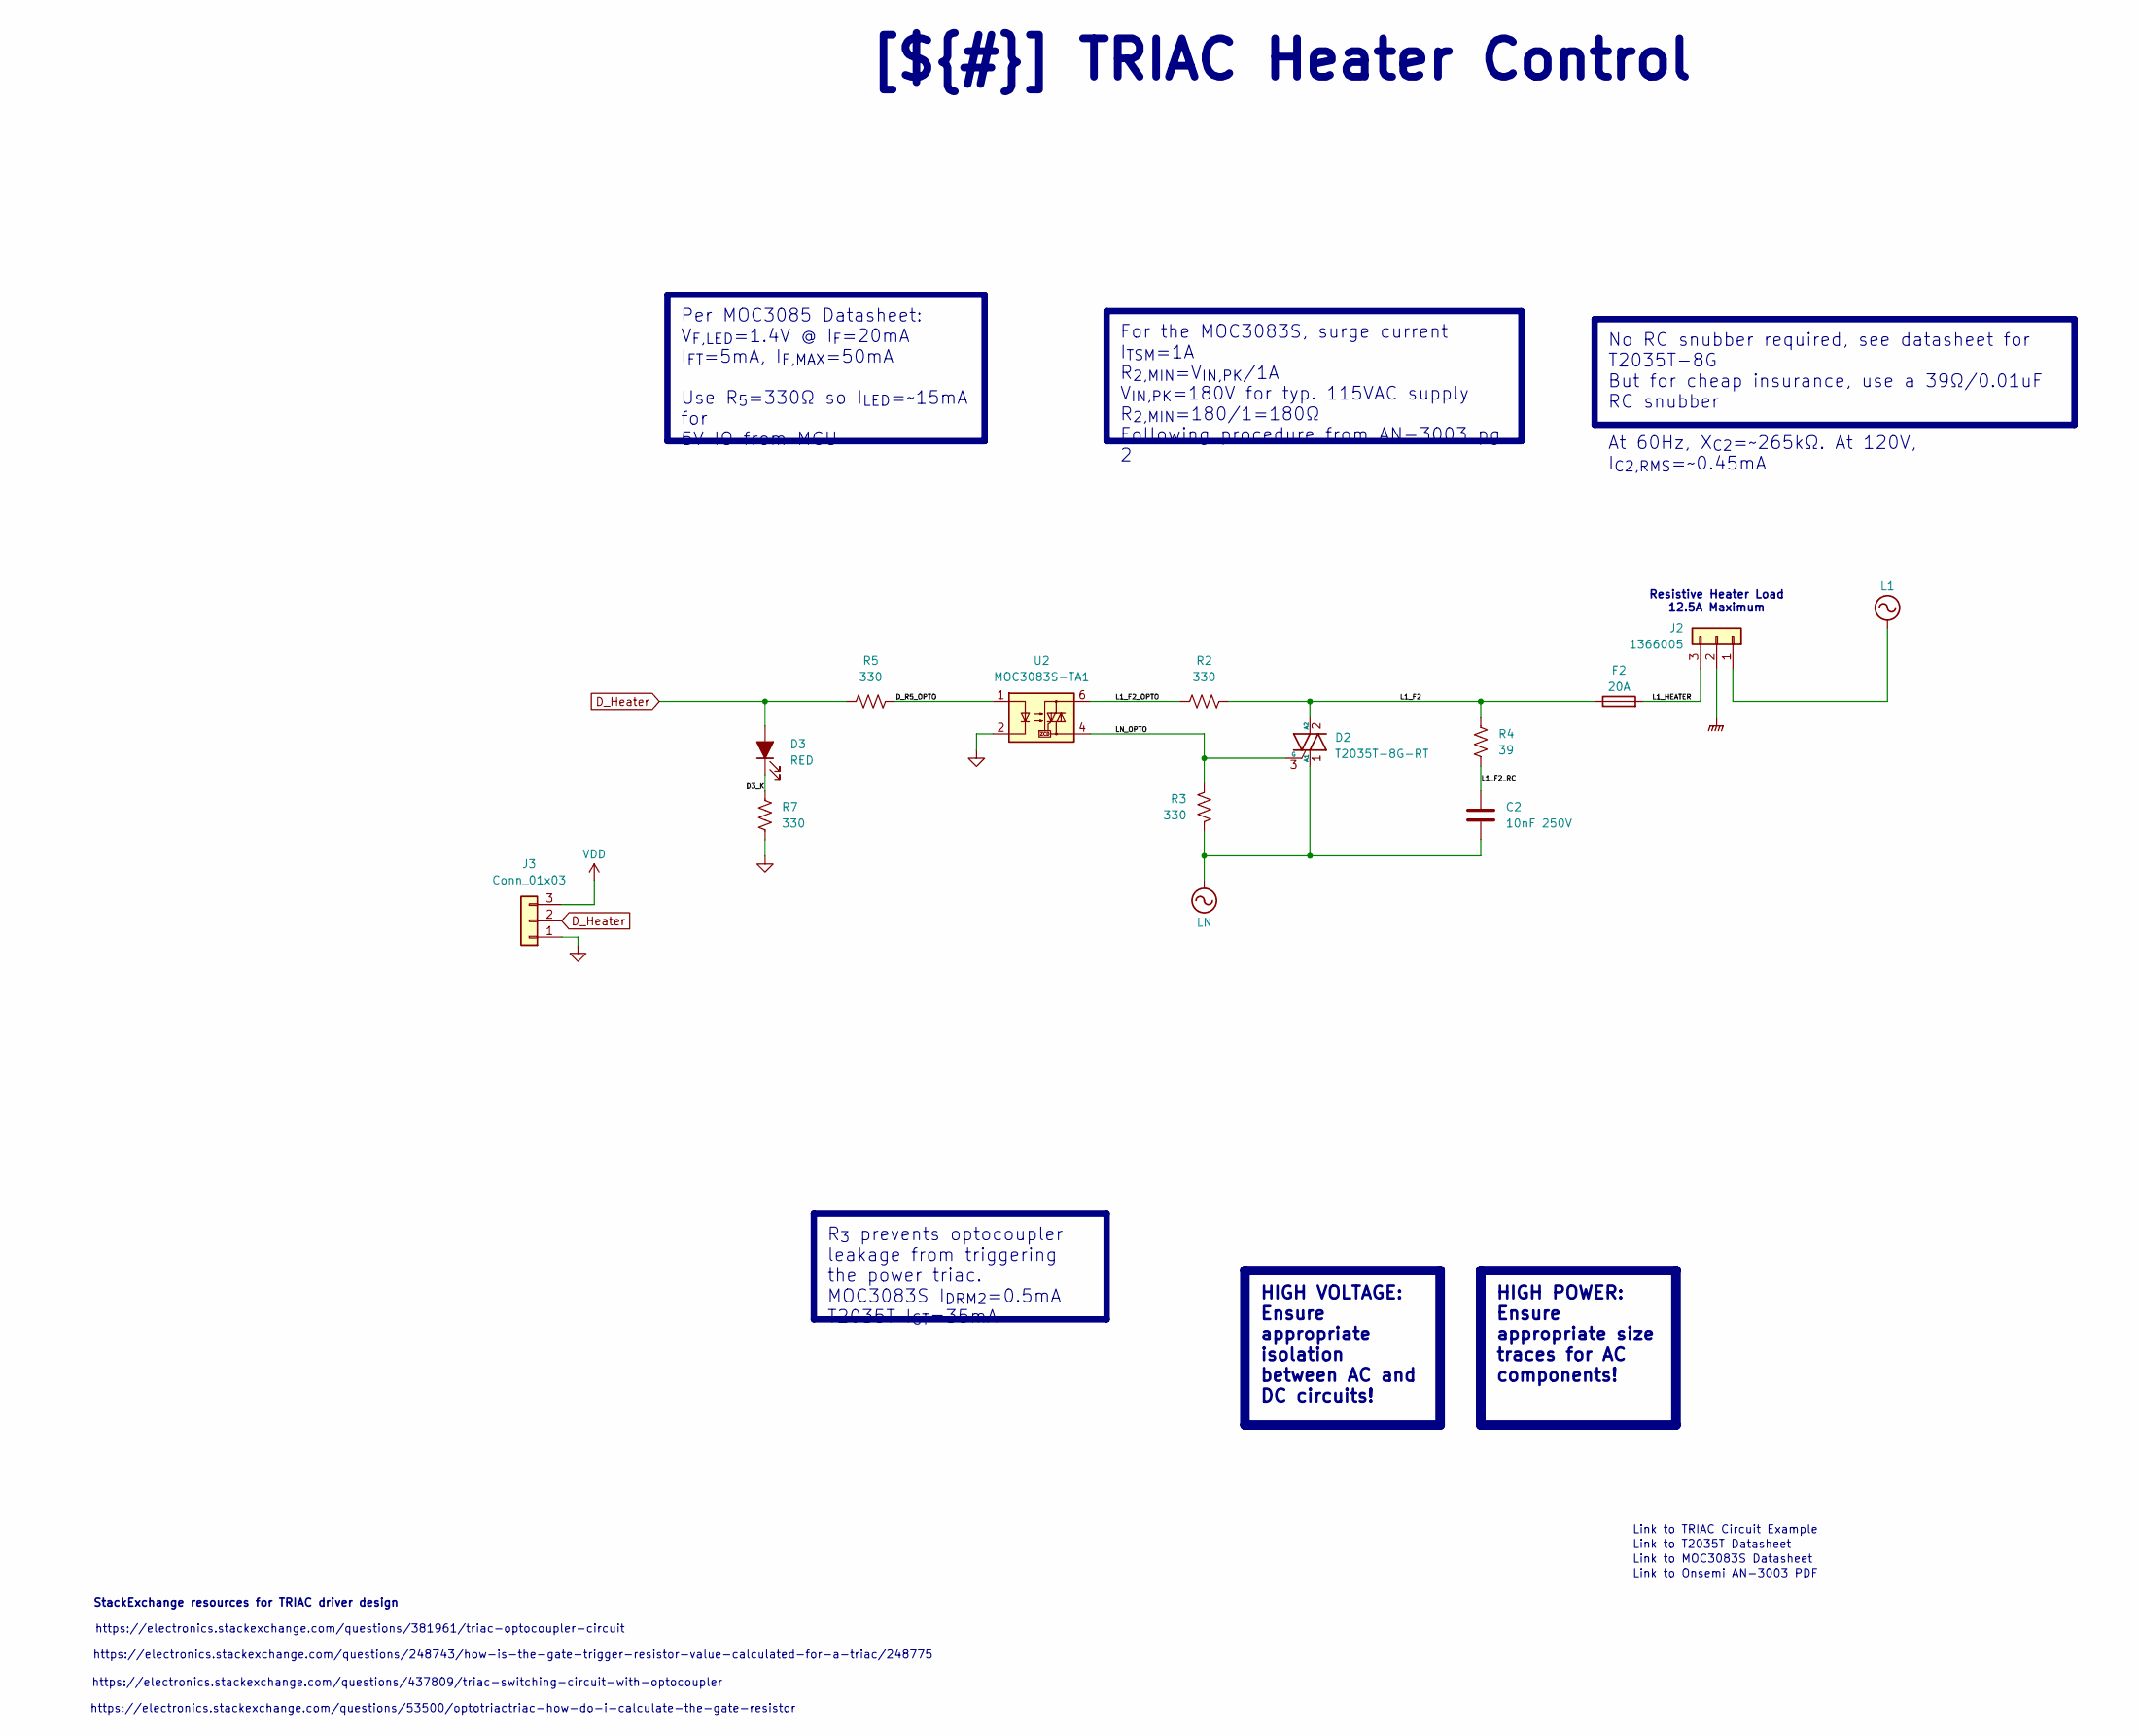
[picture p18: schematic heater.kicad_sch, TRIAC Heater Control]

Parts:
C2: 10nF 250V; C_1812_4532Metric_Pad1.57x3.40mm_HandSolder
D2: T2035T-8G-RT; TO-263-2
D3: RED; LED_0603_1608Metric_Pad1.05x0.95mm_HandSolder
F2: 20A; Fuseholder_Clip-6.3x32mm_Littelfuse_122_Inline_P34.21x7.62m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
J2: 1366005; SPTA-THR 2.53-5.0 P26
J3: Conn_01x03; JST_PH_B3B-PH-K_1x03_P2.00mm_Vertical
R2, R3: 330; R_2512_6332Metric_Pad1.40x3.35mm_HandSolder
R4: 39; R_2512_6332Metric_Pad1.40x3.35mm_HandSolder
R5, R7: 330; R_0603_1608Metric_Pad0.98x0.95mm_HandSolder
U2: MOC3083S-TA1; SMDIP-6_W9.53mm

Connections:
/Project Architecture/Heater Control/D3_K: D3.1 (K), R7.1
/Project Architecture/Heater Control/D_R5_OPTO: R5.2, U2.1
/Project Architecture/Heater Control/L1_F2: D2.2 (A2), F2.1, R2.2, R4.2
/Project Architecture/Heater Control/L1_F2_OPTO: R2.1, U2.6
/Project Architecture/Heater Control/L1_F2_RC: C2.1, R4.1
/Project Architecture/Heater Control/L1_HEATER: F2.2, J2.3
/Project Architecture/Heater Control/LN_OPTO: D2.3 (G), R3.2, U2.4
D_Heater: D3.2 (A), J3.2, R5.1
GND: J3.1, R7.2, U2.2; also elsewhere on the board
GNDPWR: J2.2; also elsewhere on the board
L1: J2.1; also elsewhere on the board
LN: C2.2, D2.1 (A1), R3.1; also elsewhere on the board
VDD: J3.3; also elsewhere on the board

Notes on the sheet:
https://electronics.stackexchange.com/questions/437809/triac-switching-circuit-with-optocoupler
Link to TRIAC Circuit Example
Link to Onsemi AN-3003 PDF
Resistive Heater Load 12.5A Maximum
Link to T2035T Datasheet
https://electronics.stackexchange.com/questions/248743/how-is-the-gate-trigger-resistor-value-calculated-for-a-triac/248775
Link to MOC3083S Datasheet
https://electronics.stackexchange.com/questions/53500/optotriactriac-how-do-i-calculate-the-gate-resistor
https://electronics.stackexchange.com/questions/381961/triac-optocoupler-circuit
StackExchange resources for TRIAC driver design
Per MOC3085 Datasheet: V_{F,LED}=1.4V @ I_{F}=20mA I_{FT}=5mA, I_{F,MAX}=50mA Use R_{5}=330Ω so I_{LED}=~15mA for 5V IO from MCU
HIGH VOLTAGE: Ensure appropriate isolation between AC and DC circuits!
R_{3} prevents optocoupler leakage from triggering the power triac. MOC3083S I_{DRM2}=0.5mA T2035T I_{GT}=35mA
HIGH POWER: Ensure appropriate size traces for AC components!
No RC snubber required, see datasheet for T2035T-8G But for cheap insurance, use a 39Ω/0.01uF RC snubber At 60Hz, X_{C2}=~265kΩ. At 120V, I_{C2,RMS}=~0.45mA
[${#}] ${TITLE}
For the MOC3083S, surge current I_{TSM}=1A R_{2,MIN}=V_{IN,PK}/1A V_{IN,PK}=180V for typ. 115VAC supply R_{2,MIN}=180/1=180Ω Following procedure from AN-3003 pg. 2

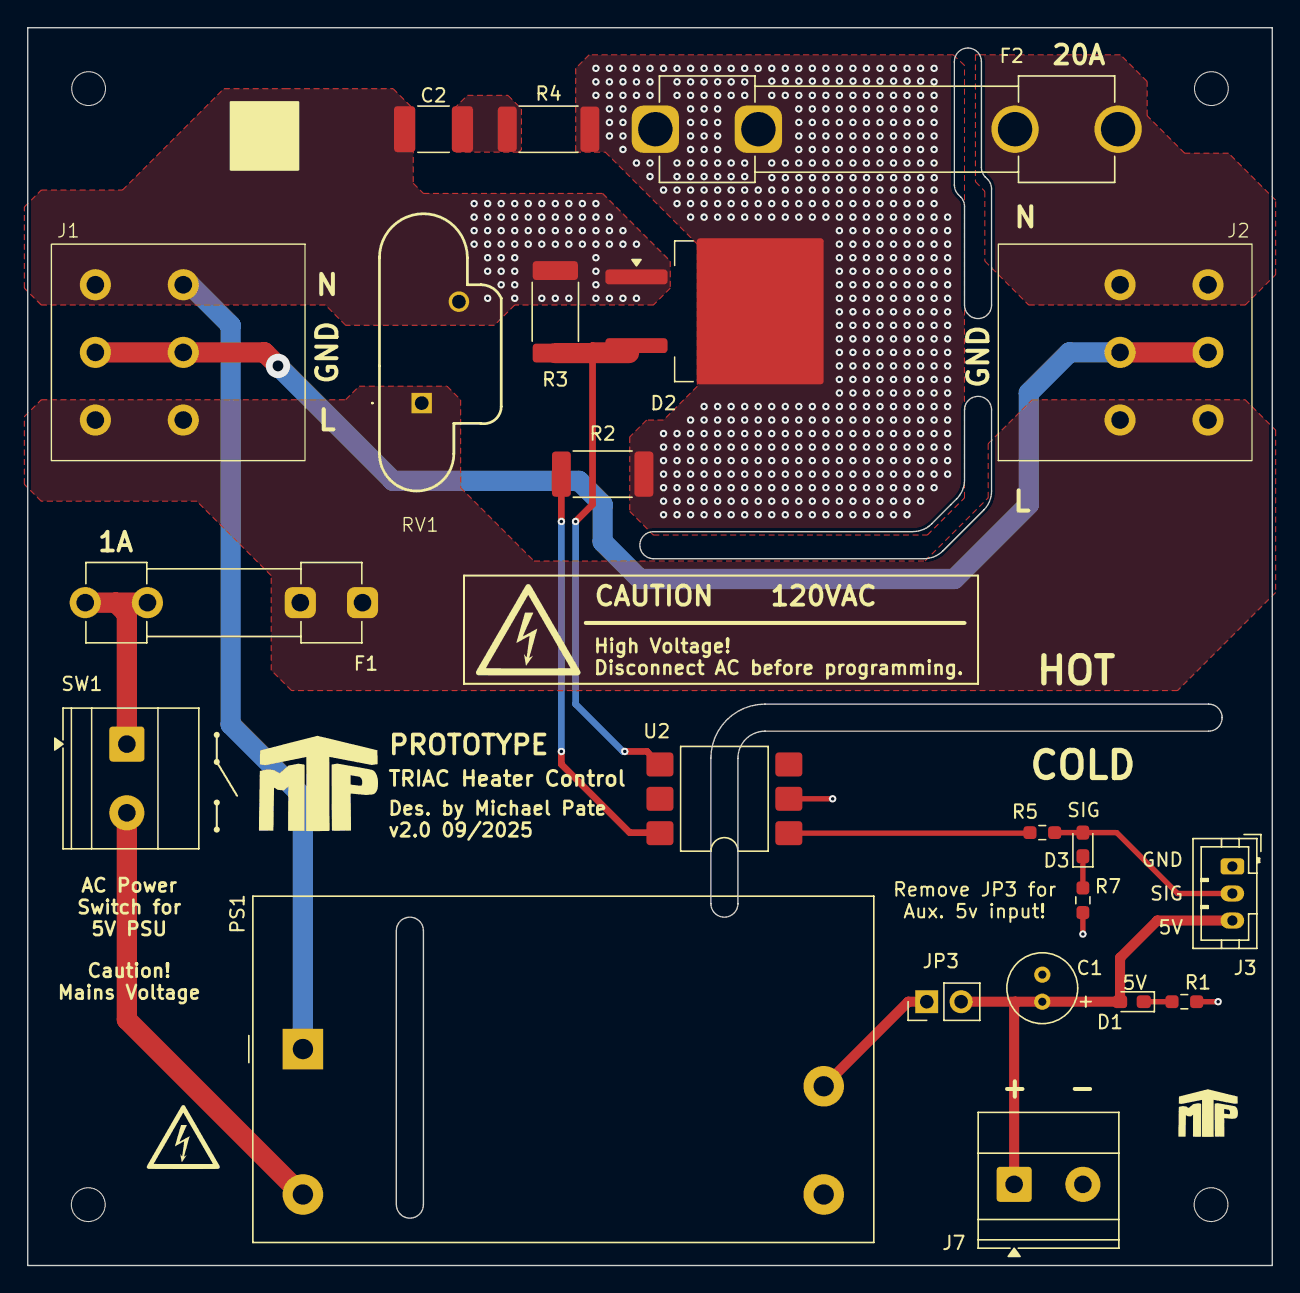
[picture p19: board powerBoard.kicad_pcb from above]

Board: 2 copper layers, 92.0 x 91.5 mm, 26 parts (0 on the bottom side), 17 nets.
