MichaelPate/Reflow-Oven-Controller/Hardware/UI Board/ui-board/ui-board.kicad_pcb

## KiCad design Hardware/UI Board/ui-board/ui-board.kicad_pcb (2025-10-19)

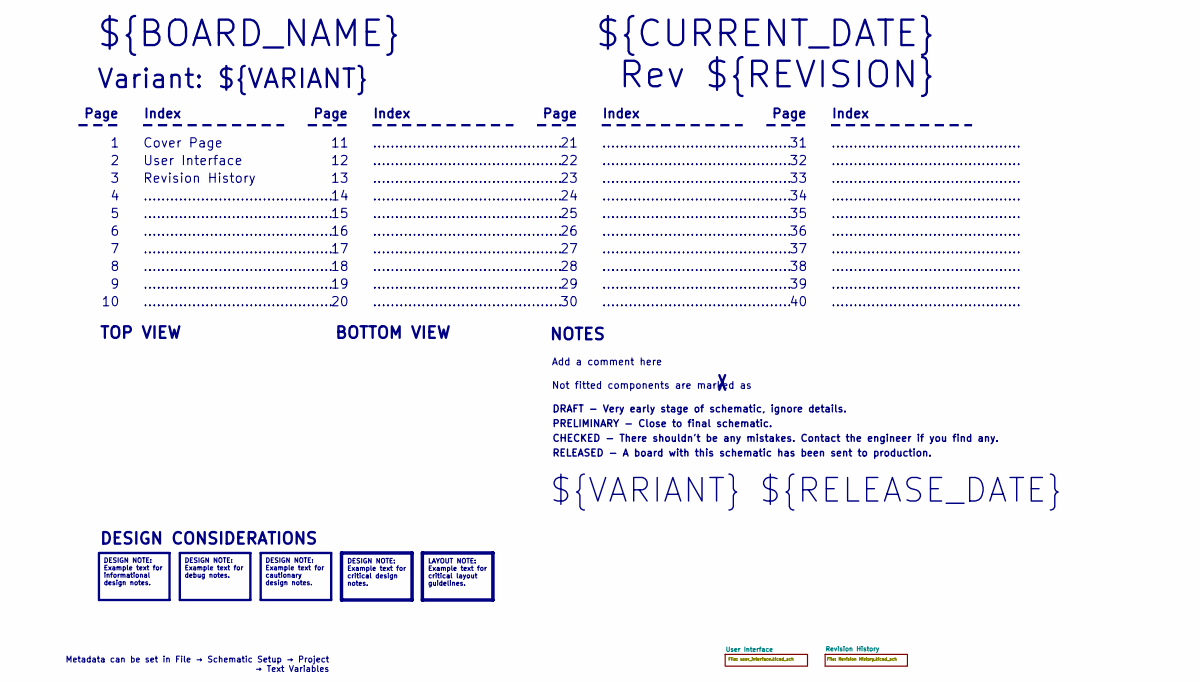
[picture p20: schematic ui-board.kicad_sch, Cover Page]

Notes on the sheet:
BOTTOM VIEW
...........................................
RELEASED - A board with this schematic has been sent to production.
Page
TOP VIEW
Not fitted components are marked as
Index
PRELIMINARY - Close to final schematic.
${VARIANT} ${RELEASE_DATE}
${CURRENT_DATE}
Variant: ${VARIANT}
Rev ${REVISION}
${BOARD_NAME}
DRAFT - Very early stage of schematic, ignore details.
User Interface
Add a comment here
Cover Page
NOTES
Revision History
CHECKED - There shouldn't be any mistakes. Contact the engineer if you find any.
DESIGN CONSIDERATIONS
Metadata can be set in File → Schematic Setup → Project → Text Variables
DESIGN NOTE: Example text for informational design notes.
LAYOUT NOTE: Example text for critical layout guidelines.
DESIGN NOTE: Example text for cautionary design notes.
DESIGN NOTE: Example text for debug notes.
DESIGN NOTE: Example text for critical design notes.
