MichaelPate/Reflow-Oven-Controller/Hardware/UI Board/ui-board/ui-board.kicad_pcb

## KiCad design Hardware/UI Board/ui-board/ui-board.kicad_pcb (continued)

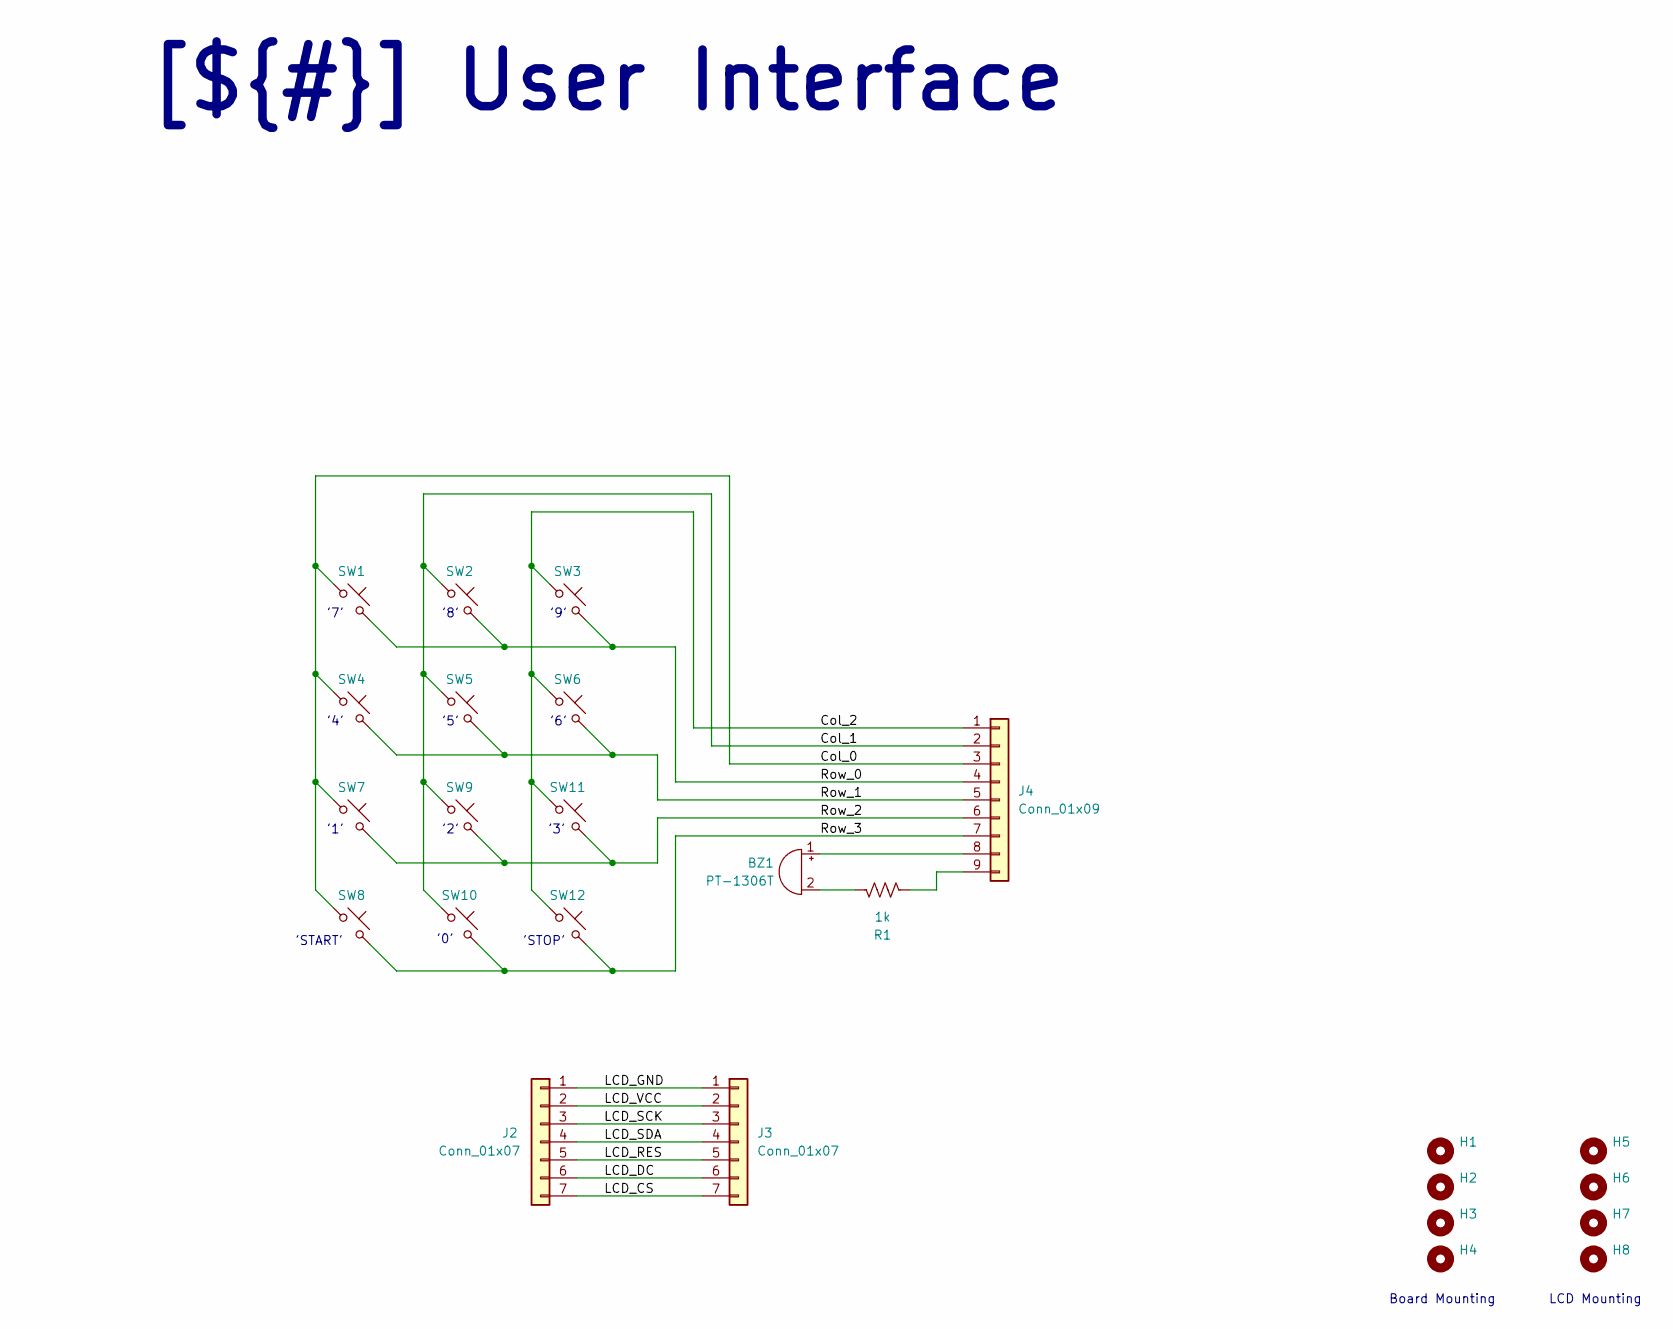
[picture p21: schematic user_interface.kicad_sch, User Interface]

Parts:
BZ1: PT-1306T; Buzzer_12x9.5RM7.6
H1, H2, H3, H4: MountingHole; MountingHole_3.2mm_M3
H5, H6, H7, H8: MountingHole; MountingHole_2.2mm_M2
J2: Conn_01x07; PinSocket_1x07_P2.54mm_Vertical
J3: Conn_01x07; PinHeader_1x07_P2.54mm_Vertical
J4: Conn_01x09; PinHeader_1x09_P2.54mm_Vertical
R1: 1k; R_Axial_DIN0204_L3.6mm_D1.6mm_P5.08mm_Horizontal
SW1, SW2, SW3, SW4, SW5, SW6, SW7, SW8, SW9, SW10, SW11, SW12: SW_Push_45deg; SW_Cherry_MX_1.00u_PCB

Connections:
/User Interface/Col_0: J4.3, SW1.1, SW4.1, SW7.1, SW8.1
/User Interface/Col_1: J4.2, SW2.1, SW5.1, SW9.1, SW10.1
/User Interface/Col_2: J4.1, SW3.1, SW6.1, SW11.1, SW12.1
/User Interface/LCD_CS: J2.7, J3.7
/User Interface/LCD_DC: J2.6, J3.6
/User Interface/LCD_GND: J2.1, J3.1
/User Interface/LCD_RES: J2.5, J3.5
/User Interface/LCD_SCK: J2.3, J3.3
/User Interface/LCD_SDA: J2.4, J3.4
/User Interface/LCD_VCC: J2.2, J3.2
/User Interface/Row_0: J4.4, SW1.2, SW2.2, SW3.2
/User Interface/Row_1: J4.5, SW4.2, SW5.2, SW6.2
/User Interface/Row_2: J4.6, SW7.2, SW9.2, SW11.2
/User Interface/Row_3: J4.7, SW8.2, SW10.2, SW12.2
unnamed: BZ1.1 (+), J4.8
unnamed: BZ1.2 (-), R1.1
unnamed: J4.9, R1.2

Notes on the sheet:
'1'
'STOP'
LCD Mounting
'7'
'0'
Board Mounting
'3'
'START'
'6'
'2'
'9'
'8'
'4'
'5'
[${#}] ${TITLE}


Notes on the sheet:
- _________________________________ - _________________________________ - _________________________________ - _________________________________ - _________________________________ - _________________________________ - _________________________________ - _________________________________ - _________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
DD.MM.YYYY - xxx Revision Variant: xxx
[${#}] ${TITLE}

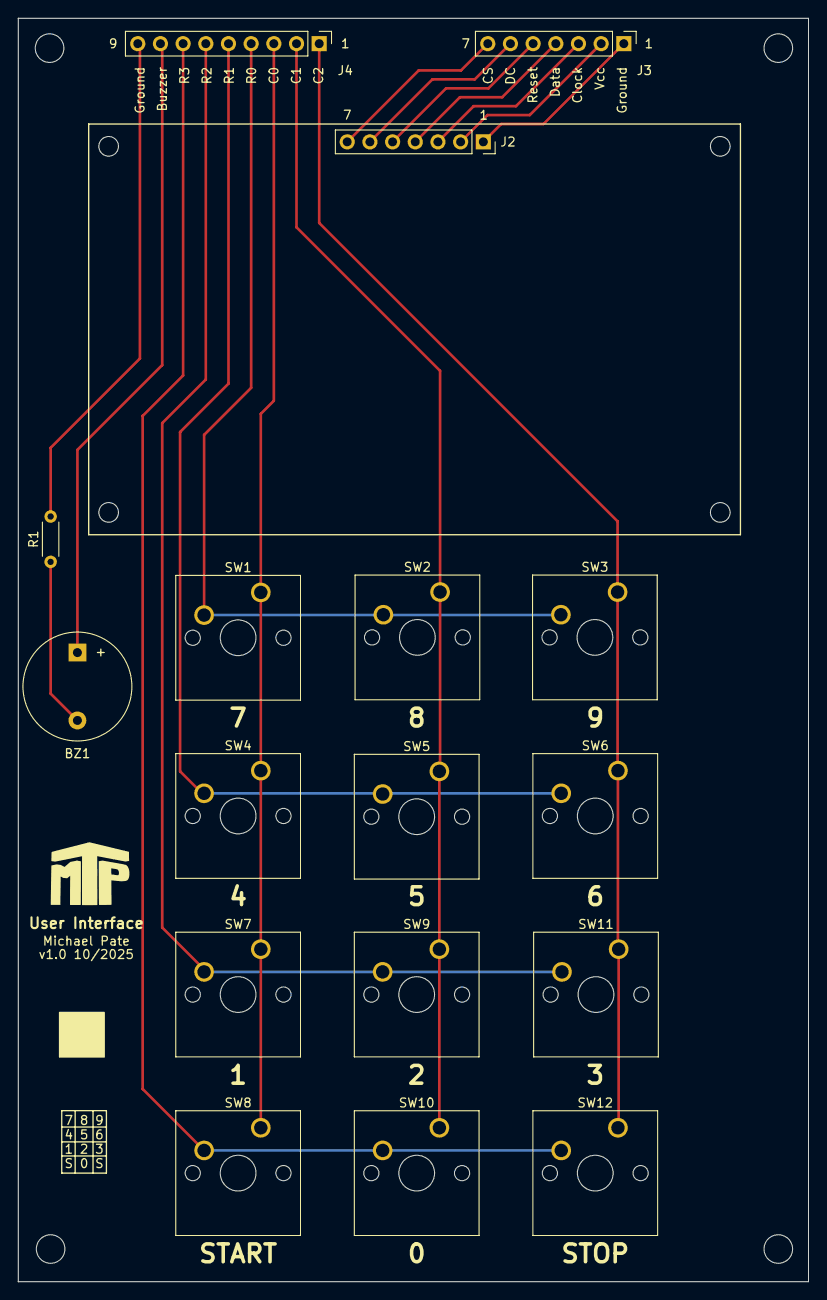
[picture p22: board ui-board.kicad_pcb from above]

Board: 2 copper layers, 88.5 x 141.5 mm, 25 parts (0 on the bottom side), 17 nets.
