MichaelPate/Reflow-Oven-Controller/Aux Boards/LED Board/LED_board_reflow_oven_test/LED_board_reflow_oven_test.kicad_pcb

## KiCad design Aux Boards/LED Board/LED_board_reflow_oven_test/LED_board_reflow_oven_test.kicad_pcb (2025-08-24)

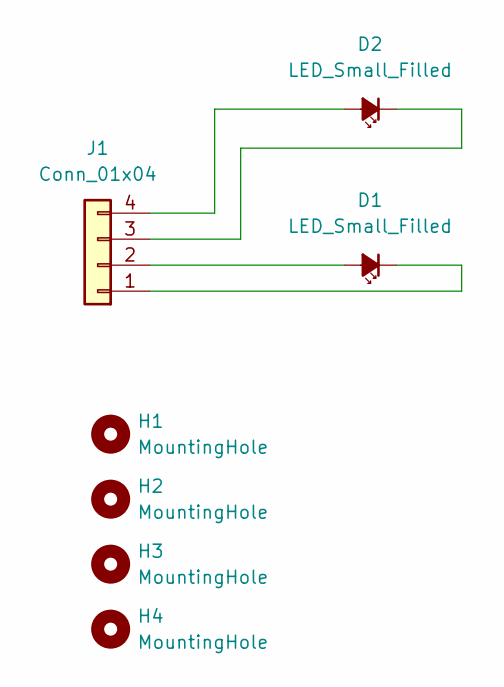
[picture p23: schematic LED_board_reflow_oven_test.kicad_sch]

Parts:
D1, D2: LED_Small_Filled; LED_D5.0mm
H1, H2, H3, H4: MountingHole; MountingHole_2.2mm_M2
J1: Conn_01x04; JST_PH_S4B-PH-K_1x04_P2.00mm_Horizontal

Connections:
unnamed: D1.2 (A), J1.2
unnamed: D1.1 (K), J1.1
unnamed: D2.2 (A), J1.4
unnamed: D2.1 (K), J1.3

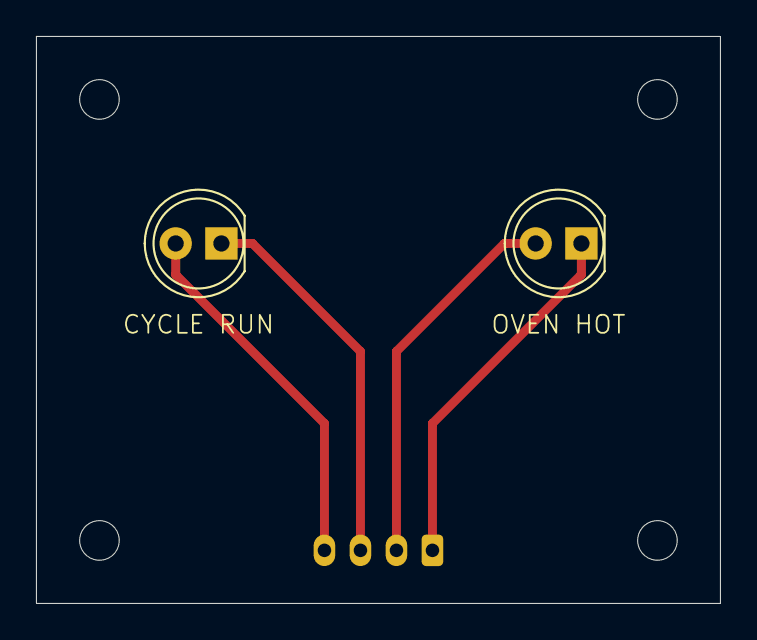
[picture p24: board LED_board_reflow_oven_test.kicad_pcb from above]

Board: 4 copper layers, 38.0 x 31.5 mm, 7 parts (1 on the bottom side), 4 nets.
