MichaelPate/Reflow-Oven-Controller/Aux Boards/Button Board/button_board/button_board.kicad_pcb

## KiCad design Aux Boards/Button Board/button_board/button_board.kicad_pcb (2025-08-24)

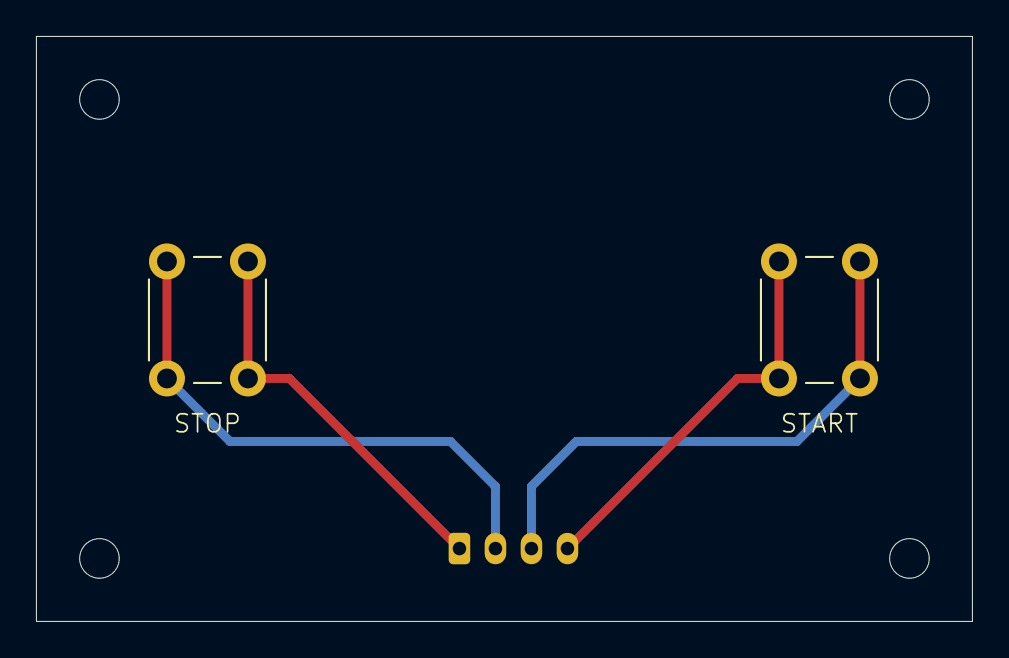
[picture p25: board button_board.kicad_pcb from above]

Board: 4 copper layers, 52.0 x 32.5 mm, 7 parts (1 on the bottom side), 4 nets.

Parts:
H1, H2, H3, H4: MountingHole; MountingHole_2.2mm_M2
J1: Conn_01x04; JST_PH_S4B-PH-K_1x04_P2.00mm_Horizontal
SW1, SW2: SW_Push; SW_PUSH_6mm_H5mm

Connections:
unnamed: J1.1, SW2.2
unnamed: J1.2, SW2.1
unnamed: J1.3, SW1.2
unnamed: J1.4, SW1.1
