MichaelPate/Reflow-Oven-Controller/Control Board/Control Board.kicad_pcb

## KiCad design Control Board/Control Board.kicad_pcb (2025-08-24)

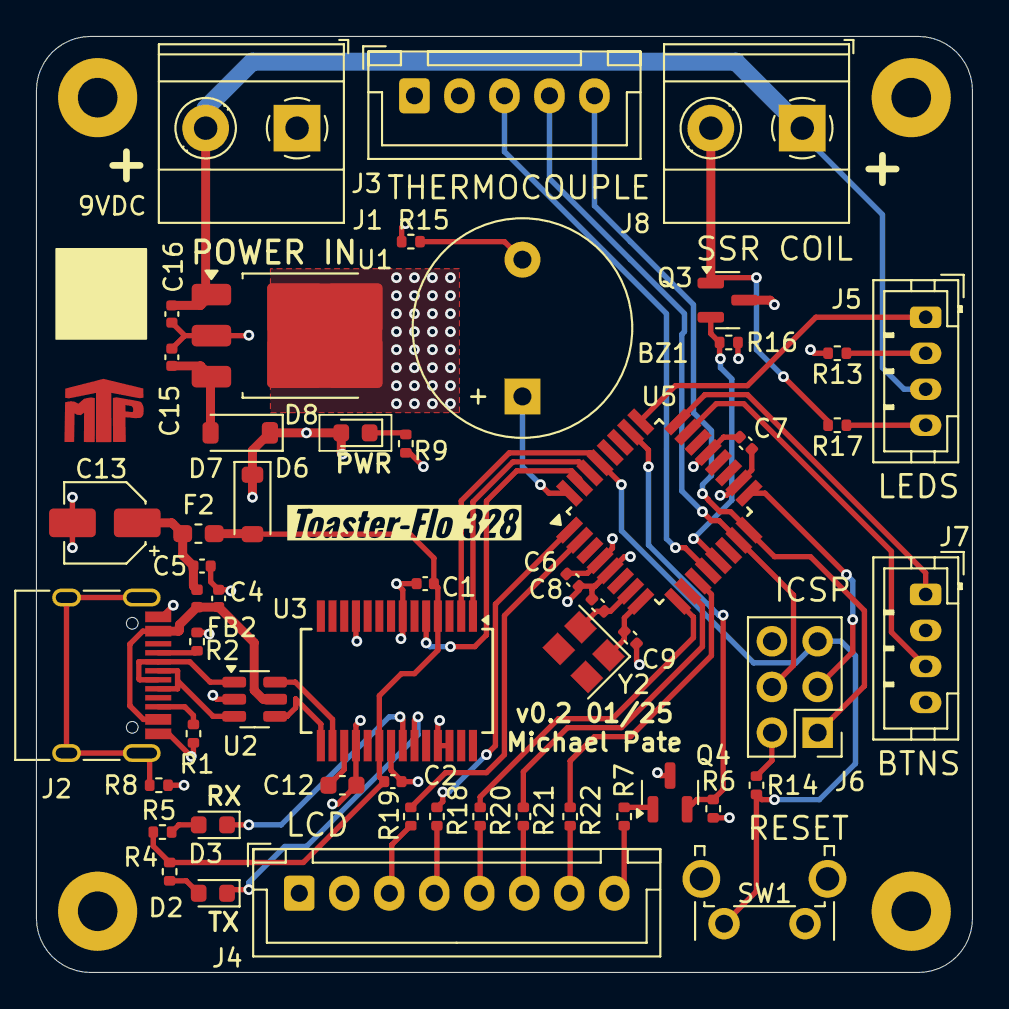
[picture p26: board Control Board.kicad_pcb from above]

Board: 4 copper layers, 52.0 x 52.0 mm, 58 parts (0 on the bottom side), 51 nets.

Parts:
BZ1: Buzzer; Buzzer_12x9.5RM7.6
C1, C2, C5, C6, C7, C15: 100n; C_0402_1005Metric
C4: 10n; C_0402_1005Metric
C8, C9: 22p; C_0402_1005Metric
C12: 1u; C_0603_1608Metric
C13: 4u7; CP_Elec_4x5.4
C16: 220n; C_0402_1005Metric
D2, D3, D8: RED; LED_0603_1608Metric
D6, D7: MBR0520T1G-JSM; D_SOD-123
F2: 0603L020/6XR; Fuse_0603_1608Metric_Pad1.05x0.95mm_HandSolder
FB2: 33R100MHz; L_0402_1005Metric
H1, H2, H3, H4: MountingHole_Pad; MountingHole_2.2mm_M2_Pad
J1, J8: Conn_01x02; TerminalBlock_Phoenix_MKDS-1,5-2-5.08_1x02_P5.08mm_Horizont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
J2: USB_C_Receptacle_USB2.0_14P; USB_C_Receptacle_HRO_TYPE-C-31-M-12
J3: Conn_01x05; JST_XH_B5B-XH-A_1x05_P2.50mm_Vertical
J4: Conn_01x08; JST_XH_B8B-XH-A_1x08_P2.50mm_Vertical
J5, J7: Conn_01x04; JST_PH_B4B-PH-K_1x04_P2.00mm_Vertical
J6: Conn_02x03_Counter_Clockwise; PinHeader_2x03_P2.54mm_Vertical
Q3, Q4: AO3414-HXY; SOT-23
R1, R2: 5k1; R_0402_1005Metric
R4, R5, R15, R19: 1k; R_0402_1005Metric
R6, R14, R16, R17, R18, R20, R21, R22: 10k; R_0402_1005Metric
R7: 330; R_0402_1005Metric
R8: 0; R_0402_1005Metric
R9, R13: 470; R_0402_1005Metric
SW1: SW_Push; SW_Tactile_SPST_Angled_PTS645Vx58-2LFS
U1: L7805; TO-252-3_TabPin2
U2: USBLC6-2SC6; SOT-23-6
U3: FT232RL; SSOP-28_5.3x10.2mm_P0.65mm
U5: ATmega328PB-A; TQFP-32_7x7mm_P0.8mm
Y2: 16MHz; Crystal_SMD_3225-4Pin_3.2x2.5mm

Connections:
+3V3: C12.1, U3.17 (3V3OUT)
+5V: C15.2, D7.2 (A), U1.3 (OUT)
+9V: C16.2, J1.2, J5.3, J8.1, U1.1 (IN)
/Connectors/LCD_BL: J4.8, R7.1
/Connectors/SSR1_LED_K: J5.4, R17.1
/Microcontroller/AVR_RX: U3.1 (TXD), U5.30 (PD0)
/Microcontroller/AVR_TX: U3.5 (RXD), U5.31 (PD1)
/Microcontroller/BUZZER: BZ1.1 (+), U5.32 (PD2)
/Microcontroller/RXL_A: D3.2 (A), R5.1
/Microcontroller/RXL_K: D3.1 (K), U3.22 (CBUS1)
/Microcontroller/TXL_A: D2.2 (A), R4.1
/Microcontroller/TXL_K: D2.1 (K), U3.23 (CBUS0)
/Microcontroller/XTAL1: C8.2, U5.7 (XTAL1/PB6), Y2.2
/Microcontroller/XTAL2: C9.2, U5.8 (XTAL2/PB7), Y2.1
/Power Supply and USB/CC1: J2.A5 (CC1), R2.2
/Power Supply and USB/CC2: J2.B5 (CC2), R1.2
/Power Supply and USB/D+_IN: J2.A6 (D+), J2.B6 (D+), U2.3 (I/O2)
/Power Supply and USB/D-_IN: J2.A7 (D-), J2.B7 (D-), U2.1 (I/O1)
/Power Supply and USB/VBUS_IN: C4.2, FB2.1, J2.A4 (VBUS), J2.A9 (VBUS), J2.B4 (VBUS), J2.B9 (VBUS), U2.5 (VBUS)
AVR_RST: J6.5, R14.1, SW1.2, U3.2 (DTR), U5.29 (~RESET/PC6)
AVR_SSR1: Q3.2 (G), R16.1, U5.13 (PB1)
BTN1: J7.3, U5.23 (PC0)
BTN2: J7.1, U5.24 (PC1)
GND: C1.1, C2.1, C4.1, C5.1, C6.1, C7.1, C8.1, C9.1, C12.2, C13.2, C15.1, C16.1, H1.1, H2.1, H3.1, H4.1, J1.1, J2.A1 (GND), J2.A12 (GND), J2.B1 (GND), J2.B12 (GND), J3.1, J4.2, J6.6, J7.2, J7.4, Q3.3 (S), Q4.3 (S), R1.1, R2.1, R6.2, R8.2, R9.2, R13.2, R15.1, R16.2, SW1.1, U1.2 (GND), U2.2 (GND), U3.7 (GND), U3.11 (CTS), U3.18 (GND), U3.21 (GND), U3.25 (AGND), U3.26 (TEST), U5.5 (GND), U5.21 (GND)
HI_HEAT_K: J5.2, R13.1
HI_HEAT_LED: J5.1, U5.25 (PC2)
ICSP_13: J6.3, U5.17 (PB5)
IDE_A3: Q4.2 (G), R6.1, U5.26 (PC3)
LCD_CLK: J4.7, R22.2
LCD_CS: J4.3, R19.2
LCD_DC: J4.5, R20.2
LCD_DIN: J4.6, R21.2
LCD_RST: J4.4, R18.2
unnamed: BZ1.2 (-), R15.2
unnamed: C5.2, C13.1, F2.1, FB2.2
unnamed: D8.1 (K), R9.1
unnamed: J2.S1 (SHIELD), R8.1
unnamed: J8.2, Q3.1 (D), R17.2
unnamed: Q4.1 (D), R7.2
unnamed: R18.1, U5.1 (PD3)
unnamed: R19.1, U5.2 (PD4)
unnamed: R20.1, U5.9 (PD5)
unnamed: R21.1, U5.10 (PD6)
unnamed: R22.1, U5.11 (PD7)
TC_CLK: J3.3, U5.12 (PB0)
TC_CS: J3.4, J6.4, U5.15 (PB3)
TC_DAT: J3.5, J6.1, U5.16 (PB4)
USB_DM: U2.6 (I/O1), U3.16 (USBD-)
USB_DP: U2.4 (I/O2), U3.15 (USBD+)
VBUS: C1.2, C2.2, D6.2 (A), F2.2, R4.2, R5.2, U3.4 (VCCIO), U3.20 (VCC)
VCC: C6.2, C7.2, D6.1 (K), D7.1 (K), D8.2 (A), J3.2, J4.1, J6.2, R14.2, U5.4 (VCC), U5.18 (AVCC)
