MichaelPate/Reflow-Oven-Controller/Software/STM Testing Code/Keypad OLED State Machine/Core/Inc/main.h

#define Button_Pin GPIO_PIN_13
#define Button_GPIO_Port GPIOC
#define MAX6675_SO_Pin GPIO_PIN_2
#define MAX6675_SO_GPIO_Port GPIOC
#define C0_Output_Pin GPIO_PIN_0
#define C0_Output_GPIO_Port GPIOA
#define C1_Output_Pin GPIO_PIN_1
#define C1_Output_GPIO_Port GPIOA
#define C2_Output_Pin GPIO_PIN_4
#define C2_Output_GPIO_Port GPIOA
#define LED_BUILTIN_Pin GPIO_PIN_5
#define LED_BUILTIN_GPIO_Port GPIOA
#define MAX6675_CLK_Pin GPIO_PIN_10
#define MAX6675_CLK_GPIO_Port GPIOB
#define Buzzer_Pin GPIO_PIN_7
#define Buzzer_GPIO_Port GPIOC
#define MAX6675_CS_Pin GPIO_PIN_8
#define MAX6675_CS_GPIO_Port GPIOA
#define R0_Input_Pin GPIO_PIN_3
#define R0_Input_GPIO_Port GPIOB
#define R1_Input_Pin GPIO_PIN_4
#define R1_Input_GPIO_Port GPIOB
#define R2_Input_Pin GPIO_PIN_5
#define R2_Input_GPIO_Port GPIOB
#define R3_Input_Pin GPIO_PIN_6
#define R3_Input_GPIO_Port GPIOB
