MichaelPate/Reflow-Oven-Controller/(commit log)

2025-08-24 Add revision 1 files
    [Control Board-B_Cu.gbl, Control Board-B_Mask.gbs, Control Board-B_Paste.gbp, Control Board-B_Silkscreen.gbo, Control Board-Edge_Cuts.gm1, Control Board-F_Cu.gtl, Control Board-F_Mask.gts, Control Board-F_Paste.gtp]
2025-08-24 add new rev2 project
    [ReflowOvenController.kicad_pcb, ReflowOvenController.kicad_sch]
2025-08-24 initial layout
    [ReflowOvenController.kicad_sch]
2025-08-25 add rev1 files for changing into rev2
    [ReflowOvenController.kicad_sch, controller.kicad_sch, peripherals.kicad_sch, power-supply.kicad_sch, ssr-driver.kicad_sch]
2025-08-28 Switch v2 design to template
    [Block Diagram.kicad_sch, Power - Sequencing.kicad_sch, Project Architecture.kicad_sch, Reflow-Controller-v2.kicad_pcb, Reflow-Controller-v2.kicad_sch, ReflowOvenController.kicad_pcb, ReflowOvenController.kicad_sch, Revision History.kicad_sch]
2025-08-29 Finish preparing the template for v2 design
    [Block Diagram.kicad_sch, Heater-Control.kicad_sch, Interface.kicad_sch, Microcontroller.kicad_sch, Power - Sequencing.kicad_sch, Power-Supply.kicad_sch, Project Architecture.kicad_sch, Reflow-Controller-v2.kicad_sch]
2025-08-29 Draft power supply and TRIAC driver circuits
    [Heater-Control.kicad_sch, Power-Supply.kicad_sch]
2025-08-29 add resource links
    [Heater-Control.kicad_sch]
2025-08-29 draft microcontroller and interface circuits, still need to finish interfaces
    [Heater-Control.kicad_sch, Interface.kicad_sch, Microcontroller.kicad_sch]
2025-09-08 work on PCB layout
    [Heater-Control.kicad_sch, Interface.kicad_sch, Microcontroller.kicad_sch, Power-Supply.kicad_sch, Reflow-Controller-v2.kicad_pcb]
2025-09-08 Move notes on schematic
    [Power-Supply.kicad_sch]
2025-09-08 add silkscreen to bottom of board
    [Reflow-Controller-v2.kicad_pcb]
2025-09-08 change to glass fuses instead of blade fuses
    [Reflow-Controller-v2.kicad_pcb]
2025-09-09 got most HV routed
    [Heater-Control.kicad_sch, Power-Supply.kicad_sch, Reflow-Controller-v2.kicad_pcb]
2025-09-09 add external 5v input and move stuff around on board
    [Power-Supply.kicad_sch, Reflow-Controller-v2.kicad_pcb]
2025-09-09 change silkscreen
    [Reflow-Controller-v2.kicad_pcb]
2025-09-09 add initial project for power board
    [Block Diagram.kicad_sch, Power - Sequencing.kicad_sch, Project Architecture.kicad_sch, Revision History.kicad_sch, Section A - Title A.kicad_sch, Section B - TItle B.kicad_sch, power-board.kicad_pcb, power-board.kicad_sch]
2025-09-09 Import schematics from single-board design
    [Project Architecture.kicad_sch, Revision History.kicad_sch, heater.kicad_sch, power-board.kicad_sch, power.kicad_sch]
2025-09-10 schematic mostly done, start board layout
    [heater.kicad_sch, power-board.kicad_pcb, power.kicad_sch]
2025-09-12 add isolation to pcb design
    [power-board.kicad_pcb]
2025-09-14 pcb design
    [power-board.kicad_pcb, power.kicad_sch]
2025-09-20 PCB layout is generally complete
    [heater.kicad_sch, power-board.kicad_pcb, power.kicad_sch]
2025-09-20 generate production files
    [power-board.kicad_pcb]
2025-09-20 Revise project structure
    [Block Diagram.kicad_sch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]
2025-09-24 Fix 3D Models, readjust traces on power board
    [powerBoard.kicad_pcb]
2025-09-26 work on power board layout
    [powerBoard.kicad_pcb]
2025-10-18 generate gerbers for power board fab
    [designators.csv, positions.csv, powerBoard.kicad_pcb]
2025-10-18 complete schematic for power board
    [Project Architecture.kicad_sch, Revision History.kicad_sch, powerBoard.kicad_sch]
2025-10-18 New project for temperature front end
    [Block Diagram.kicad_sch, Power - Sequencing.kicad_sch, Project Architecture.kicad_sch, Revision History.kicad_sch, Section A - Title A.kicad_sch, Section B - TItle B.kicad_sch, front-end.kicad_pcb, front-end.kicad_sch]
2025-10-18 save project template to new version
    [Block Diagram.kicad_sch, Power - Sequencing.kicad_sch, Project Architecture.kicad_sch, Revision History.kicad_sch, Section A - Title A.kicad_sch, Section B - TItle B.kicad_sch, front-end.kicad_sch]
2025-10-18 Project template fully initialized
    [Section B - TItle B.kicad_sch, front-end.kicad_pcb, front-end.kicad_sch]
2025-10-18 fix typo in page numbers
    [front-end.kicad_sch]
2025-10-18 Analog schematic substantially complete
    [Section B - TItle B.kicad_sch]
2025-10-18 Add some notes to the schematic
    [Section B - TItle B.kicad_sch]
2025-10-18 Add references
    [Section B - TItle B.kicad_sch]
2025-10-18 Fix typo in notes on gain
    [Section B - TItle B.kicad_sch]
2025-10-18 Add footprints to schematic
    [Section B - TItle B.kicad_sch]
2025-10-18 Add parts to PCB and get models. Layout can now begin
    [Section B - TItle B.kicad_sch, front-end.kicad_pcb]
2025-10-18 Rename files
    [Interface.kicad_sch, front-end.kicad_pcb, front-end.kicad_sch]
2025-10-18 PCB layout complete, ready for routing
    [Interface.kicad_sch, front-end.kicad_pcb]
2025-10-18 PCB routing complete, ready for production
    [front-end.kicad_pcb]
2025-10-18 Add test points for inter stages
    [Interface.kicad_sch, front-end.kicad_pcb]
2025-10-18 Sent PCB to production, add images to schematic
    [bom.csv, designators.csv, front-end.kicad_pcb, front-end.kicad_sch, positions.csv]
2025-10-18 power and analog boards sent to production
2025-10-18 Template set up
    [Block Diagram.kicad_sch, Power - Sequencing.kicad_sch, Project Architecture.kicad_sch, Revision History.kicad_sch, Section A - Title A.kicad_sch, Section B - TItle B.kicad_sch, ui-board.kicad_pcb, ui-board.kicad_sch]
2025-10-18 Add keypad to schematic
    [ui-board.kicad_pcb, user_interface.kicad_sch]
2025-10-19 board complete and fab files generated, sent to fab
    [bom.csv, designators.csv, positions.csv, ui-board.kicad_pcb, ui-board.kicad_sch, user_interface.kicad_sch]
2025-10-19 regenerated fab files and sent to fab
    [bom.csv, positions.csv, ui-board.kicad_pcb, user_interface.kicad_sch]
2025-10-24 Change AC-DC supply fuse holder part number, ordered the wrong one
    [power.kicad_sch, powerBoard.kicad_pcb]
2025-10-27 Arduino demo for OLED is working
2026-01-16 STM32 OLED Demo
2026-01-18 Blinking LED is working
2026-01-18 STM32 OLED with HAL is working. Add 5x7 font for text
2026-01-25 Add all work up to now
    [Block Diagram.kicad_sch, Interface.kicad_sch, Power - Sequencing.kicad_sch, Project Architecture.kicad_sch, Revision History.kicad_sch, Section A - Title A.kicad_sch, Section B - TItle B.kicad_sch, bom.csv]
2026-01-25 Rearrange files
    [Block Diagram.kicad_sch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]
