MichaelPate/Reflow-Oven-Controller/(notices)

Notices in the files:
Software/STM Testing Code/Keypad OLED State Machine/Core/Inc/main.h:
Copyright (c) 2025 STMicroelectronics.
All rights reserved.
This software is licensed under terms that can be found in the LICENSE file
